wuxinyou/05-XBotHighCtrlBox/02-核心板/软件设计-历史/qtxbot4412_20170221_2/images/start副本.png

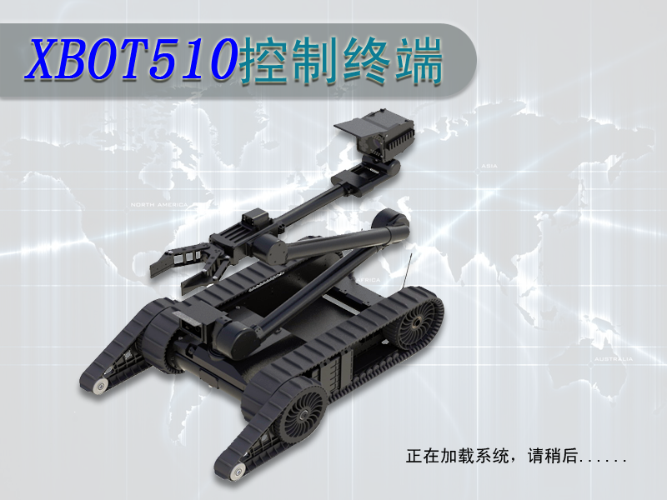
02-核心板/软件设计-历史/qtxbot4412_20170221_2/images/start副本.png
