wuxinyou/05-XBotHighCtrlBox/02-核心板/软件设计-历史/qtxbot4412_20170221/images/start.png

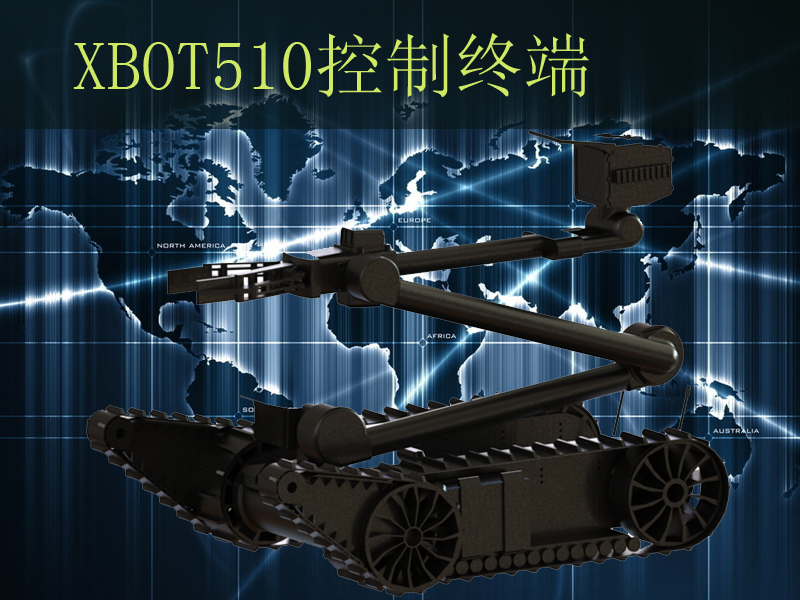
02-核心板/软件设计-历史/qtxbot4412_20170221/images/start.png
