wuxinyou/05-XBotHighCtrlBox/03-基板/软件设计/XbotUpCtrlBoxV2.2.2/ReadMe.txt

XbotUpCtrlBoxV2.1
20170427
1.本程序适用于新版的基板，实现电源开关软自锁。

XbotUpCtrlBoxV2.1
20170427
1.修改波特率

XbotUpCtrlBoxV2.2.2
20170428
1.添加PB12：PowerOutCnt：用于控制核心板上电.
