wuxinyou/05-XBotHighCtrlBox/03-基板/电气设计/CT310高端控制盒基板电路设计/CT310高端控制盒基板电路V1.1/ReadMe.txt

CT310高端控制盒基板电路V1.1
20170428
1.添加PB12：PowerOutCnt：用于控制核心板上电
