wuxinyou/05-XBotHighCtrlBox/02-核心板/软件设计/qtxbot4412_20170427/ReadMe.txt

qtxbot4412_20170221
1.根据最新的qtxbot程序初步移植到4412上
2.主要移植的是摄像头和串口。
3.屏蔽了原来的串口，视屏，3D
4.使用了4412的串口和视频。
5.编译通过，生成可执行文件，但是不可运行。

qtxbot4412_20170221_2
1.去掉4412的串口和视屏后，可以运行。
2.不使用VideoDis，而是直接使用ProcessImage后可以采集视屏。

qtxbot4412_20170221_3
1.采集视屏正常。
2.修改2D显示区的贴图，因为不能显示中文，同时改变了2D显示窗口的大小。
3.模式标签不能显示中文，修改待定。

qtxbot4412_20170221_4
1.添加串口,根据最新协议修改程序数据帧。
2.基本实现串口通信，采用最新协议。
3.实现视屏采集，2D窗口显示。
4.是一个功能基本完善的版本。

qtxbot4412_20170222_1
1.完善串口收发数据的正确性，合理性。
2.该版本添加了发送数据
3.正常接收，发送合理的数据帧，功能基本完善。
4.数据不是很合理，接收数据帧有延迟。

qtxbot4412_20170222_2
1.添加信号强度指示，待测试。
2.修改电量更新显示的问题。
3.接收机器人数据有问题。

qtxbot4412_20170407
1.时隔2个月，重新测试功能。
2.完善了接收数据延迟的问题，将remoteDataIncoming()放在run()中，同时要start线程。
	解决了接收延迟的问题。
3.信号强度只有在接收到机器人数据后才能显示。只有在解决了接收延迟的问题后，
	才能正常显示。
4.问题：接收到的机器人数据和协议有点出入。

qtxbot4412_20170407_2
1.重点解决接收机器人数据和协议有出入的问题。。。
2.在调试Modle_2d时需要将成员disflag=true.
3.添加字库，解决Modle_2d不能显示中文的问题，只要在系统文件中添加字库即可，
	无需添加任何额外代码。

qtxbot4412_20170418
1.根据协议，本体电压应该是robotData.feedData4，而不是robotData.feedData5，先修改之
2.之前使用receiveFrame统一接收基板的按键数据和机器人数据，会发生数据紊乱的情况，
	原因有2个：1.receiveFrame是联合体的，是共享内存；2.接收数据是另外一个线程，
	在处理主线程时，有可能串口接收线程会改变两个线程的共享数据。
	解决方法：分别定义机器人数据和按键数据内存，就不会了，测试通过。

qtxbot4412_20170427
1.完善图像视角被截取的问题，将图片映射到指定尺寸。
2.测试通过。
