wuxinyou/05-XBotHighCtrlBox/02-核心板/软件设计-历史/qtxbot4412_20170221/ReadMe.txt

qtxbot4412_20170221
1.根据最新的qtxbot程序初步移植到4412上
2.主要移植的是摄像头和串口。
3.屏蔽了原来的串口，视屏，3D
4.使用了4412的串口和视频。
5.编译通过，生成可执行文件，但是不可运行。
