wuxinyou/05-XBotHighCtrlBox/02-核心板/叶总资料/xbot/xbot程序集合/readme.txt

XBOT510_CtrlBox（控制箱主控程序）--------蓝色板子，使用avr下载器下载
xbot_dispaly(控制箱液晶屏控制程序)-------绿色板子，使用MDK打开	
xbot_main_ctrl(底盘磨合)-----------------底盘磨合前下载	xbot_main_ctrl(正常控制)程序，并调试好支臂，再下载此程序下载此程序前，一定要将机器人架起来	
xbot_main_ctrl(机械臂磨合)---------------底盘磨合完成，下载此程序，下载前将机器人架起来
xbot_main_ctrl(正常控制)-----------------机械臂磨合完成后，下载此程序，下载完之后一定要初步测试，然后再去测试爬楼梯以及外场测试等

 注意：下载时一定要注意安全，做好防止机器人失控的应对措施
