wuxinyou/05-XBotHighCtrlBox/03-基板/软件设计/测试软件/SerialPort20170416/SerialPort01/ReadMe.txt

SerialPort1
20161103
1.本实例测试C#开发串口调试工具
2.基本实现接收发送功能，还没有进行数据格式化。

SerialPort2
20161107
1.根据网上例程开发的C#串口调试工具
2.基本完成数据的发送和接收，包括Hex发送和接收。

SerialPort20170114
1.用于电子脚扣测试，检测电子脚扣接收信号强度，并显示1s内收到的信号。

SerialPort20170319
1.用于电子脚扣测试，连续发送电击指令，2个周期，每隔10s连续发送20帧。
	ff ff A4 01 80 09 00 00 00 00 00 00 00 2E

SerialPort20170408
1.用于高端控制盒数据帧调试。
2.用于《控制基板STM32->4412核心板：采集的机器人数据帧》的调试。
3.由于上面协议数据帧里的数据都是uint8。
4.基本测试通过，可以使用。

SerialPort20170416
