wuxinyou/05-XBotHighCtrlBox/02-核心板/核心板系统配置/配置说明/LCD更换配置.docx

LCD更换配置

1. 分辨率设置

在s3cfb_wa101s.c文件中原来7.0寸显示的拨码开关处将分辨率改为800X600

s3cfb_wa101s.c截图

2. logo设置

（1）imag2lcd设置生成.c数组

imag2lcd截图

（2） 改变内核驱动s3cfb_ops.c

通过top和left的值可以修改logo在屏幕中的位置，通过i和j值的修改可以改变屏幕的清晰度去除条纹，一般i和j的值与logo分辨率相同。

s3cfb_ops.c截图

3. 内核设置

如果不进行内核设置，在更换完分辨率和logo之后开发板会持续重启

内核配置截图

4. 屏幕显示为下图

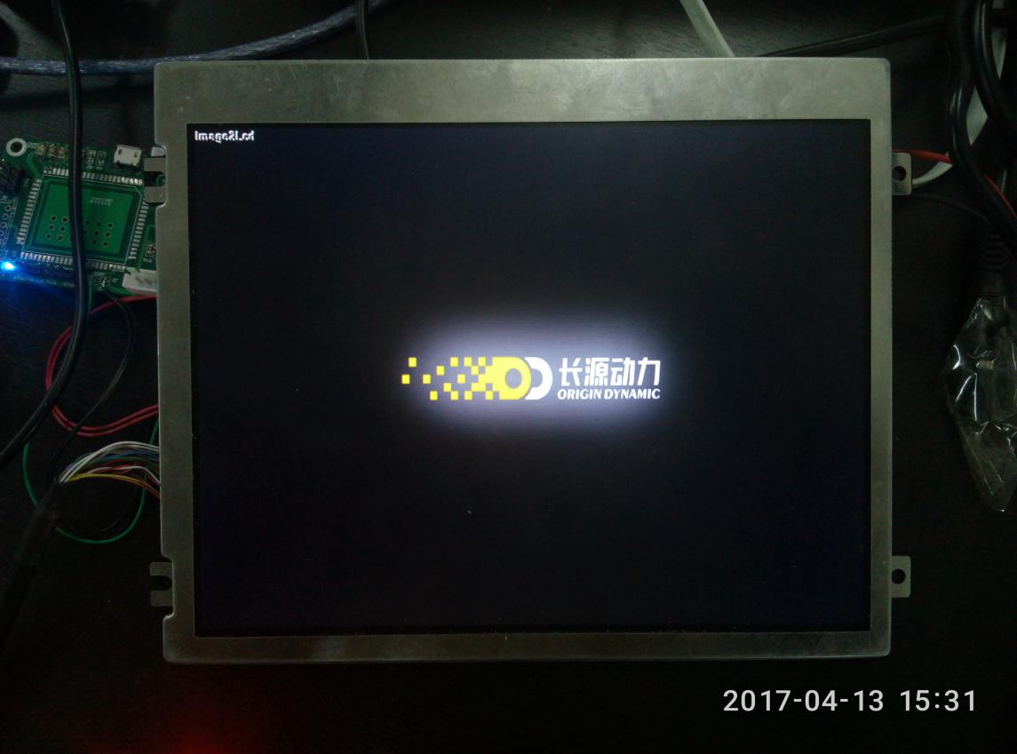
[picture p23: figure]
屏幕截图

5.本文件中包含新logo所需的驱动代码iTop-4412.h
