wuxinyou/05-XBotHighCtrlBox/03-基板/历史/【1】高端控制器整理完成/【3】高端控制盒文档/XBOT控制盒文档资料/XBOT高级控制盒资料/按键开关.docx

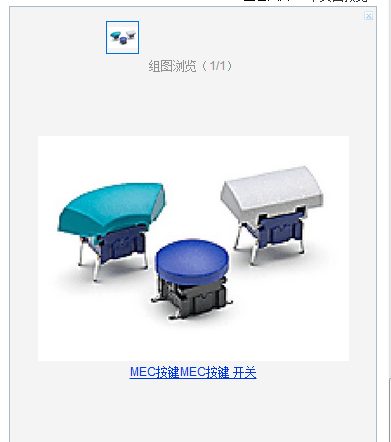
[picture p24: figure]
