wuxinyou/05-XBotHighCtrlBox/05-产品生产/生产文档/3.焊接料单/CT310高端控制盒核心板电路V1.3(ok).xlsx

CT310高端控制盒核心板电路V1.3
参数 | 丝印 | 封装 | 数量 | 备注
CR1220 | BAT1 | BAT1 | 1 | 外购件
22uF/10V | C1, C118 | C1206-S | 2
0.1uF/10V | C2, C112, C117, C129, C130 | C0603-S | 5
10uF/10V | C3 | C0603-S | 1
2.2uF | C4, C6 | C0603-S | 2
0.1uF | C5, C7, C10, C11, C12, C13, C14, C15, C19, C24, C25, C26, C28, C29, C30, C31, C32, C33, C35, C38, C39, C43, C44, C45, C46, C47, C48, C49, C57, C58, C60, C79, C80 | C0603-S | 33
1uF | C8, C9, C16 | C0603-S | 3
0.1uF/NC | C17, C18, C20, C21, C40, C148, C149, C150 | C0603-S | 8 | 不焊
22pF | C22, C23, C36, C37 | C0603-s | 4
22uF | C27, C34 | C1206-S | 2
10uF | C41, C42, C154 | C0603-s | 3
22uF | C50, C93 | C0805-s | 2
1nF | C51, C52, C53, C54, C55 | C0603-S | 5
10uF | C56, C59, C62 | C0805-S | 3
47uF/16v | C61 | C1206-S | 1
1uF/10V | C87, C88, C128 | C0603-S | 3
4.7uF | C89 | C0603-S | 1
560pF | C95 | C0603-S | 1
10nF | C96 | C0603-S | 1
CON40X2_0_8MM | CON10, CON11, con12, CON13 | CON2X40-0_5MM-BB | 4 | 外购件
IN4148 | D1, D2 | D1206 | 2
LED0603 | D3, D4, D5 | LED0603 | 3
500ma | F1 | F1812 | 1
0R/NC | F2 | F1206 | 1 | 不焊
TP_P0_0.8_D0 | H5, H6, H7, H8, H10, H12, H13, H14 | HOLE2_7 | 8
HEADER1X4 | J1 | HD1X4-2.00 | 1 | 不焊
HEADER 30X2 | J2 | HD2X30-2.00 | 1 | 母座，塑高4.6mm
HEADER 2X20 | J3 | HD2X20-2.00 | 1 | 母座，塑高4.6mm
DF19G-20P-1H | J4 | DF19G-20P-1H | 1 | 外购件
sm06b-srss-tb | J5 | sm06b-srss-tb | 1 | 外购件
FFC/SM1.0-5 | J6 | FFC/SM1.0-5 | 1 | 外购件
ZX62RD-AB-5P8 | J7 | MICRO-USB | 1 | 外购件
3.3uH/NC | L1, L2 | L4X4-S | 2 | 不焊
2.2uH | L7 | L3X3MM | 1
S8050 | Q2, Q3 | SOT-23 | 2
AO3415A | Q7 | SOT-23 | 1
8050 | Q8 | SOT-23 | 1
1K | R1, R2, R6, R105, R106 | R0603-S | 5
33K | R3 | R0603-S | 1
10K | R4, R5, R16, R24, R26, R33, R36, R39, R41, R42, R44, R48, R86, R135 | R0603-S | 14
1K/NC | R7 | R0603-S | 1
100K | R8 | R0603-S | 1
22R/NC | R9 | R0603-S | 1 | 不焊
0R | R10, R12, R18, R20, R21, R22, R23, R25, R40, R49, R50, R54, R56, R57, R174 | R0603-S | 15
10K/NC | R11, R30 | R0603-S | 2 | 不焊
37.4R | R13, R14, R19, R32 | R0603-S | 4
75R/NC | R15, R29 | R0603-S | 2 | 不焊
0R/NC | R17, R53, R55 | R0603-S | 3 | 不焊
2.2k/NC | R27, R28 | R0603-S | 2 | 不焊
15K | R31, R119, R120, R128, R129 | R0603-S | 5
49.9R | R34, R35, R37, R38 | R0805-S | 4
NC | R43, R51, R52, R89 | R0603-S | 4 | 不焊
47K | R45 | R0603-S | 1
1M | R46, R47 | R0603-S | 2
38K | R131 | R0603-S | 1
510K | R133 | R0603-S | 1
800K | R165 | R0603-S | 1
800K/NC | R173 | R0603-S | 1
RESET | SW1 | SW4-SMD | 1 | 不焊
TVP5150AM1PBSR | U1 | PFFQ32 | 1
TXS0102DCU | U2, U17 | tssop8 | 2
REG1117-3.3V | U3 | SOT-223 | 1
SP3232EEN | U4 | SO-16 | 1
TSC2004IRTJ | U5 | QFN20 | 1
DM9621ANP | U8 | QFN48-050-0707LH | 1
74ALVC164245DGG | U9 | TSSOP_48 | 1
GM8285C | U12 | TSSOP56 | 1
RT8065ZSP | U22 | soic8-lh | 1
25MHz | Y1 | X4-2_5X3_2 | 1 | (无源晶振)
14.31818MHz | Y2 | CRYSTAL_D200 | 1 | (无源晶振)
