wuxinyou/05-XBotHighCtrlBox/05-产品生产/生产文档/2.电气资料/1.PCB文件&制板信息/CT310高端控制盒制板信息.xlsx

CT210高端控制盒制板信息
序号 | 名称 | 使用地方 | 需要数量 | 层数 | 颜色 | 板材 | 板厚 | 尺寸 | 板号 | 注意信息 | 制板商
1 | CT310高端控制盒A区按键电路V1.0 | 遥控器 | 1 | 2 | 绿色 | FR4 | 2.0mm | 1.26*12.9 |  |  | 深圳顺易捷
2 | CT310高端控制盒B区按键电路V1.0 | 遥控器 | 1 | 2 | 绿色 | FR4 | 2.0mm | 1.26*12.9 |  |  | 深圳顺易捷
3 | CT310高端控制盒A区贴膜V1.0 | 遥控器 | 1 |  |  |  |  |  | 06-152A |  | 东达
4 | CT310高端控制盒B区贴膜V1.0 | 遥控器 | 1 |  |  |  |  |  | 06-152B |  | 东达
5 | CT310高端控制盒H区按键电路V1.0 | 遥控器 | 1 | 2 | 绿色 | FR4 | 1.6mm | 3.7*5.55 |  |  | 深圳顺易捷
6 | CT310高端控制盒IJ区按键电路V1.0 | 遥控器 | 2 | 2 | 绿色 | FR4 | 1.6mm | 2.4*3.5 |  |  | 深圳顺易捷
7 | CT310高端控制盒方向组合按键电路V1.0 | 遥控器 | 1 | 2 | 绿色 | FR4 | 1.6mm | 4.3*4.6 |  |  | 深圳顺易捷
8 | CT310高端控制盒核心板电路V1.3 | 遥控器 | 1 | 2 | 绿色 | FR4 | 1.6mm | 9.5*11.7 |  |  | 深圳顺易捷
9 | CT310高端控制盒基板电路V1.1 | 遥控器 | 1 | 2 | 绿色 | FR4 | 1.6mm | 15.7*20 |  |  | 深圳顺易捷
10 | CT310高端控制盒右摇杆电路V1.1 | 遥控器 | 1 | 2 | 绿色 | FR4 | 1.6mm | 3.73*3.73 |  |  | 深圳顺易捷
11 | CT310高端控制盒左摇杆电路V1.1 | 遥控器 | 1 | 2 | 绿色 | FR4 | 1.6mm | 3.73*3.73 |  |  | 深圳顺易捷
12 | CT310高端控制盒图数传接口电路V1.0 | 遥控器 | 1 | 2 | 绿色 | FR4 | 1.6mm | 1.32*4.42 |  |  | 深圳顺易捷
