wuxinyou/05-XBotHighCtrlBox/03-基板/历史/【1】高端控制器整理完成/【2】高端控制器 最终版电路板汇总/【1】XBTO高端控制盒V1.1/XBTO高端控制盒V1.1/Project Outputs for XBOT高端控制盒V1_1/控制盒基板.xlsx

Comment | Designator | Footprint | Quantity
0.1uF | C1, C4, C9, C12, C13, C24, C25, C79, C80, C85, C86, C105, C106, C108, C110, C113, C114, C115 | C0805 | 18
10uF | C2, C16, C17, C78, C81, C82, C87, C88, C112, C116, C117, C118 | C1206 | 12
15nF | C3 | C0805 | 1
470uF/50V | C5 | CT7343-E | 1
22pF | C6 | R0805 | 1
2200pF | C7 | C0805 | 1
100uF, 16V | C8 | CT7343-E | 1
22uF | C10, C11, C20, C26 | C1206 | 4
100pF | C14, C21, C27, C28, C29, C30, C31, C32, C33, C34, C35, C36, C37, C38, C39, C40, C41, C42, C43, C44, C45, C46, C47, C48, C49, C50, C51, C52, C53, C54, C55, C56, C57, C58, C59, C60, C61, C62, C63, C64, C65, C66, C67, C68, C71, C72, C73, C74 | C0805 | 48
100uF/16V | C15 | CT7343-E | 1
0.1uF | C18, C19, C119, C120, C121 | C1206 | 5
100pF | C22, C23 | C1206 | 2
1uF | C69, C70 | C0805 | 2
470uF/35V | C77, C83 | CT7343-E | 2
47uF/35V | C84 | CT7343-D | 1
0.1uF | C89, C91, C92, C93, C97, C98, C100, C101, C102, C104 | C0603 | 10
10uF | C90, C95, C96, C99 | C0805 | 4
100pF | C94, C103 | C0603 | 2
15pF | C107, C109, C111 | C0805 | 3
SM8S14A | D1, D2 | DO-218AB | 2
MBRS410LT3 | D3, D4, D5, D6 | SMC | 4
MBRS3201T3G | D7 | SMC | 1
1SMA5.0AT3G | D8, D9 | SMA-S | 2
1SMA5.0AT3G | D10, D11, D12, D13, D14, D15, D16, D17, D18, D19, D20, D21, D22, D23, D24, D25, D26, D27, D28, D29, D30, D31, D32, D33, D34, D35, D36, D37, D38, D39, D40, D41, D42, D43, D44, D45, D46, D47, D48, D49, D50, D51, D52, D53, D57, D59 | SMA | 46
1.5SMC15AT3G | D56, D58 | SMC | 2
LED-G | D60, D61 | LED0805 | 2
1.5SMC6.8CA | D62, D63, D64 | SMC | 3
2A | F1, F2, F3, F4 | F1812 | 4
SP3232EEN | IC1 | SO16-150 | 1
SP3078EEN-L/TR | IC2, IC3, IC4 | SO-8 | 3
HD1X8-2.00 | J2 | SHD1X8-2.00 | 1
Socket | J4, J5, J6, J7, J8, J9, J10, J12, J13, J14 | HT-M3 | 10
SW4 | K_H1, K_H2, K_H3, K_H4, K_H5 | SW-MEC | 5
15uH,1.5A | L1 | L5050-P | 1
15uH,1.5A | L2, L3 | L3030-P | 2
10uH | L4 | L0603-C | 1
Header 6 | P1, P20 | DS1X6-2.54 | 2
KEY_A | P2, P3 | HDR1X9 | 2
Header 8 | P6 | FFC/SM1.0-8 | 1
SMT-8P | P8 | 1MM25_8PIN_SMT_R90 | 1
Header 6 | P9, P10 | FFC/SM1.0-6 | 2
五线触摸屏接口 | P11 | DS1X5-2.54 | 1
RTC备用电池 | P12 | CR2428 | 1
备用视频输入输 | P13 | DS1X4-2.54 | 1
振动电机1 | P15 | 1MM25_2PIN_SMT_R90 | 1
Header 10 | P16, P21 | DS1X10-2.54 | 2
音频接口 | P17 | DS1X8-2.54 | 1
振动电机2 | P18 | 1MM25_2PIN_SMT_R90 | 1
8R 喇叭接口 | P19 | DS1X2-2.54 | 1
17W2 | P22 | 17W2_FEMALE | 1
Header 8 | P23, P25 | DS1X8-2.54 | 2
Header 4 | P24 | DS1X4-2.54 | 1
Header 15X2 | PA1, PB1 | HDR2X15 | 2
8050 | Q1, Q2 | SOT-23 | 2
BCP54 | Q3, Q4 | SOT-223 | 2
0K | R0 | R0603 | 1
1K | R1, R83, R84, R95, R96, R122, R123 | R0805 | 7
348K | R2 | R0805 | 1
64.9K | R3 | R0805 | 1
205K | R4 | R0805 | 1
35.7K,1% | R5 | R0805 | 1
53.6K,1% | R6 | R0805 | 1
10K | R7, R8, R11, R12, R104, R105, R106 | R0805 | 7
100K | R9, R10 | R0805 | 2
4.7K | R13, R14, R15, R16, R17, R23, R24, R25, R26, R31, R32, R33, R34, R39, R40, R41, R42, R47, R48, R49, R50, R55, R56, R59, R60, R61, R65, R66, R67, R71, R72, R73, R77, R78, R79, R85, R86, R89, R90, R93 | R0805 | 40
0.33K | R18, R19, R20, R21, R22, R27, R28, R29, R30, R35, R36, R37, R38, R43, R44, R45, R46, R51, R52, R53, R54, R57, R58, R62, R63, R64, R68, R69, R70, R74, R75, R76, R80, R81, R82, R87, R88, R91, R92, R94 | R0805 | 40
10K | R97, R98, R99 | R0603 | 3
470R | R100, R101 | R0805 | 2
4.7R | R102, R103 | R0805 | 2
2K | R107, R109, R110, R112, R113, R115 | R0805 | 6
120R(不焊) | R108, R111, R114 | R0805 | 3
10R | R116, R117, R118, R119, R120, R121 | R0805 | 6
SW-4 | S1, S2 | SW-MEC-5 | 2
TPS54160-C1 | U1 | TSSO3X5-G10 | 1
MC33275DT-3.3 | U2 | TO-252 | 1
REF192 | U3 | SO-8 | 1
TDA7267 | U4 | DIP8 | 1
STM32F103VCT6 | U5 | STM32F103VCT6 | 1
XTAL 8MHz | Y1 | XTAL 5.0X7.0-SM | 1
