wuxinyou/05-XBotHighCtrlBox/05-产品生产/生产文档/4.外购件清单/外购件清单-CT310高端控制盒20170426.xlsx

Sheet: 外购件
物料采购需求单 编号：
申请部门：生产部 |  |  | 项目名称：30套xbot高端控制盒 |  |  |  |  |  | 申请日期：2017/04/20
编号 | 物料名称 | 规格型号 | 所需数量 （个） | 库存数量 （个） | 安全库存量 （个） | 采购数量 （个） | 采购单价 （元） | 采购总价 （元） | 采购事由 | 备注
1 | 二维摇杆 |  | 2 | 0 | 10 | 100 |  |  |  | https://item.taobao.com/item.htm?id=544439099342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
2 | 8.4寸液晶屏 | LQ084S3LG03 | 1 |  |  |  |  |  |  | 15510088223，戴小姐 QQ：2721162196
3 | pcb板焊点铜柱，M3X4 |  | 4 |  |  |  |  |  |  | https://item.taobao.com/item.htm?spm=a230r.1.14.149.PJjIvW&id=42387569087&ns=1&abbucket=3#detail
4 | I,J区:丹麦MEC按键开关灰色复位开关微动开关3ATH9 + 1M 03 |  | 4 |  |  |  |  |  |  | https://item.taobao.com/item.htm?spm=2013.1.0.0.SlMnar&id=44280098442
5 | E,F区: 丹麦MEC按键开关黑色复位开关微动开关3ATH9+1ZB09 3FTH9+1ZC09 |  | 2 |  |  |  |  |  |  | https://item.taobao.com/item.htm?spm=a1z10.3-c.w4002-182903973.17.D0S9Wo&id=44336098748
6 | H区：丹麦MEC按键开关黑色复位开关微动开关3FTH9 + 1P 09 原装正品 |  | 5 |  |  |  |  |  |  | https://item.taobao.com/item.htm?spm=a1z10.3-c.w4002-182903973.10.rIws8S&id=44283862474
7 | LVDS液晶座 DF19G-20P-1H 1.0MM间距 20P 贴片针座 HRS原装 |  | 1 |  |  |  |  |  |  | https://item.taobao.com/item.htm?id=42592471726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
8 | LEMO插头插座 推拉自锁 插头插座 FGG/EGG.2B-16芯 连接器 | FGG/EGG.2B-16 | 1 |  |  |  |  |  |  | https://item.taobao.com/item.htm?spm=a230r.1.14.79. xtDNez&id=536641064705&ns=1&abbucket=19#detail
9 | LEMO插头插座 推拉自锁 插头插座 FGG/EGG.2B-19芯 连接器 | FGG/EGG.2B-19 | 1 |  |  |  |  |  |  | https://item.taobao.com/item.htm?spm=a230r.1.14.24.hjACl8&id=534446114473&ns=1&abbucket=19#detail
10 | 按钮开关GQ12系列金属球型按钮,红色球头 | GQ12B-10/J/R/A | 1 |  |  |  |  |  |  | https://detail.tmall.com/item.htm?id=35786413714&cm_id=140105335569ed55e27b&abbucket=19
11 | 按钮开关GQ12系列金属球型按钮，黑色球头 | GQ12B-10/J/N/A | 3 |  |  |  |  |  |  | https://detail.tmall.com/item.htm?id=35786413714&cm_id=140105335569ed55e27b&abbucket=19
12 | 红波按钮 不锈钢钥匙开关,1NO1NC | LAS1-AGQ-□Y∕◆● | 1 |  |  |  |  |  |  | https://detail.tmall.com/item.htm?id=35786413714&cm_id=140105335569ed55e27b&abbucket=19
13 | 红波按钮 不锈钢自复位开关,环形红色12V灯,1NO1NC | LAS2GQF-□■E∕△∕▲∕◎∕☆ | 1 |  |  |  |  |  |  | https://detail.tmall.com/item.htm?id=35786413714&cm_id=140105335569ed55e27b&abbucket=19
14 | 三星四核Exynos CortexA9开发板 iTOP-4412核心板 SCP 1GB/4GB (对接的连接器属于附属品，要说明提供，每个板子配套4个连接器) |  | 1 |  |  |  |  |  |  | https://item.taobao.com/item.htm?id=35379531422&spm=2014.21600712.0.0&qq-pf-to=pcqq.c2c
15 | 锅仔片 薄膜开关 10MM |  | 20 |  |  |  |  |  |  | https://detail.tmall.com/item.htm?id=43782987769&cm_id=140105335569ed55e27b&abbucket=3
16 | 1.2G图传接收机(只需要接收机)(同XBOT机器人控制箱使用的图传) |  | 1
17 | 433MHz数传，19200波特率，485接口，7.2V供电(同XBOT机器人本体使用的数传) |  | 1 |  |  |  |  |  |  | 深圳华奥通
18 | 12V电池，131x56x21mm，用3200mah的18650电芯做，保护板持续电流3A，保护电流5A |  | 1 |  |  |  |  |  |  | 定制
19 | 12V继电器,6脚，2路常开 | G6B-2214P-US-12V | 2 |  |  |  |  |  |  | https://item.taobao.com/item.htm?spm=a230r.1.14.22.dBAQNm&id=41733682965&ns=1&abbucket=3#detail
20 | microUSB母座 |  | 1 |  |  |  |  |  |  | https://detail.tmall.com/item.htm?id=42481773625&ali_trackid=1_7aaa746ca6c8d28d7c58046034fdf01c
21 | 1.2G天线BNC接头，同XBOT控制箱 |  | 1
22 | 433MHz天线，通XBOT控制箱 |  | 1
23
24
25
26
27
28
29
30
31
32
33
34
35
36
37
38
39
40
41

Sheet: 接插件&线材
接插件&线材清单
序号 | 元件 名称 | 参数 型号 | 单套 数量 | 单价 | 小计 | 购买 数量 | 购买 单价 | 小计 | 备注 | 购买 时间 | 供应商 | 联系 方式
1 | ZH1.5mm间距 2P，卧贴，配套胶壳 | ZH1X2WT-1.5 | 2 |  |  |  |  |  |  |  | https://item.taobao.com/item.htm?spm=a1z10.5-c.w4002-828583740.21.CnEtvi&id=41924865971
2 | ZH1.5mm间距 9P，卧贴，配套胶壳 | ZH1X9WT-1.5 | 4
3 | ZH1.5mm间距 5P，卧贴，配套胶壳 | ZH1X5WT-1.5 | 4
4 | ZH1.5mm间距 8P，卧贴，配套胶壳 | ZH1X8WT-1.5 | 2
5 | ZH1.5mm间距 4P，卧贴，配套胶壳 | ZH1X4WT-1.5 | 4
6 | ZH1.5mm间距 2P，卧贴，配套胶壳 | ZH1X2WT-1.5 | 1
7 | ZH1.5mm间距 7P，卧贴，配套胶壳 | ZH1X7WT-1.5 | 2
8 | ZH1.5mm间距 4P，立贴，配套胶壳 | ZH1X4LT-1.5 | 3
9 | ZH1.5mm间距 5P，立贴，配套胶壳 | ZH1X5LT-1.5 | 3
10 | ZH1.5mm间距 6P，立贴，配套胶壳 | ZH1X6LT-1.5 | 2
11 | ZH1.5mm间距 7P，立贴，配套胶壳 | ZH1X7LT-1.5 | 1
12 | 1.5mm配套线材，双头线，不插，长度60mm | 颜色，黄 | 50条 |  |  |  |  |  |  |  | https://item.taobao.com/item.htm?spm=a230r.1.14.286.kTlnd3&id=40034991481&ns=1&abbucket=3#detail
13 | 1.5mm配套线材，双头线，不插，长度60mm | 颜色，黑 | 10条
14 | 1.5mm配套线材，双头线，不插，长度60mm | 颜色，红 | 10条
15 | 1.0MM间距6P卧贴,带胶壳，带线，线长100mm | sm06b-srss-tb | 1 |  |  |  |  |  |  |  | https://item.taobao.com/item.htm?spm=a230r.1.14.8.eNyoXl&id=38889497402&ns=1&abbucket=3#detail
16 | 液晶屏20P屏线定制，线长60mm |  | 1 |  |  |  |  |  |  |  | 杨鑫，QQ1055212134，手机：13683364748
17 | 2.00mm间距双排母，塑高4.6mm |  | 2 |  |  |  |  |  |  |  | https://item.taobao.com/item.htm?spm=a230r.1.14.41.4Dnwr3&id=522572885533&ns=1&abbucket=3#detail
18 | 2.00mm间距双排针，正常高度 |  | 1
19 | DC电源线母接头5.5mm |  | 1 |  |  |  |  |  |  |  | https://item.taobao.com/item.htm?spm=a230r.1.14.304.zlGXAq&id=539126918394&ns=1&abbucket=3#detail
20 | BNC带法兰转SMA内螺纹内针，总长130mm |  | 2 |  |  |  |  |  |  |  | https://item.taobao.com/item.htm?spm=a230r.1.14.37.Qp1W1a&id=532194905742&ns=1&abbucket=3#detail
21 | 双排针,双塑2.54间距,针长30mm |  | 1 |  |  |  |  |  |  |  | https://item.taobao.com/item.htm?spm=a1z10.5-c.w4002-1531767097.34.1V0uZ1&id=40039912006
22 | 贴片排母2.54mm间距 母座2*12Pin插座 |  | 1 |  |  |  |  |  |  |  | https://item.taobao.com/item.htm?spm=a1z10.5-c.w4002-1531767097.37.1V0uZ1&id=39425247827
23
24
25
26
27
28
29
30
31
32
33
34
35
