wuxinyou/05-XBotHighCtrlBox/05-产品生产/生产文档/3.焊接料单/CT310高端控制盒A区按键电路V1.0(ok).xlsx

CT310高端控制盒A区按键电路V1.0
参数 | 丝印 | 封装 | 数量 | 备注
ZH1X9LT-1.5 | J1 | ZH1X9LT-1.5 | 1 | 外购件-接插件
HEADER1X2 | J2, J3, J4, J5, J6, J7, J8, J9 | 薄膜按键 | 8 | 外购件-锅仔片
