wuxinyou/05-XBotHighCtrlBox/05-产品生产/生产文档/3.焊接料单/CT310高端控制盒H区按键电路V1.0(ok).xlsx

CT310高端控制盒H区按键电路V1.0
参数 | 丝印 | 封装 | 数量 | 备注
ZH1X6WT-1.5 | J1 | ZH1X6WT-1.5 | 1 | 外购件
SW4 | K_H1, K_H2, K_H3, K_H4, K_H5 | SW-MEC | 5 | 外购件
