wuxinyou/05-XBotHighCtrlBox/05-产品生产/生产文档/3.焊接料单/CT310高端控制盒IJ区按键电路V1.0(ok).xlsx

CT310高端控制盒IJ区按键电路V1.0
参数 | 丝印 | 封装 | 数量 | 备注
ZH1X5LT-1.5 | J1 | ZH1X5LT-1.5 | 1 | 外购件-接插件
ZH1X4LT-1.5 | J2 | ZH1X4LT-1.5 | 1 | 外购件-接插件
SW-MEC | J3, J4 | SW-MEC | 2 | 外购件-MEC按键
