wuxinyou/05-XBotHighCtrlBox/05-产品生产/生产文档/3.焊接料单/CT310高端控制盒右摇杆电路V1.1(ok).xlsx

CT310高端控制盒右摇杆电路V1.1
参数 | 丝印 | 封装 | 数量 | 备注
H20JH | J1 | H20JH | 1 | 摇杆，外购件
ZH1X4WT-1.5 | J2 | ZH1X4WT-1.5 | 1
