wuxinyou/05-XBotHighCtrlBox/05-产品生产/生产文档/3.焊接料单/CT310高端控制盒图数传接口电路V1.0(ok).xlsx

CT310高端控制盒图数传接口电路V1.0
参数 | 丝印 | 封装 | 数量 | 备注
HD2X12S-2.54 | J1 | HD2X12S-2.54 | 1 | 外购件-2.54mm间距母座
ZH1X4LT-1.5 | J2 | ZH1X4LT-1.5 | 1 | 外购件
ZH1X6LT-1.5 | J3 | ZH1X6LT-1.5 | 1 | 外购件
ZH1X5LT-1.5 | J4 | ZH1X5LT-1.5 | 1 | 外购件
