wuxinyou/05-XBotHighCtrlBox/05-产品生产/生产文档/3.焊接料单/CT310高端控制盒基板电路V1.1(ok).xlsx

CT310高端控制盒基板电路V1.1
参数 | 丝印 | 封装 | 数量 | 备注
100uF/25V | C1, C7, C8, C19, C20, C53, C72, C86 | CT7343-E-S | 8
2.2uF | C2, C68 | C1206 | 2
0.1uF | C3, C5, C9, C10, C11, C17, C18, C21, C70, C73, C74, C80, C83, C105, C106, C108, C113, C114, C115 | C0805 | 19
22uF | C4, C6, C79, C84 | C1206 | 4
100pF | C12, C13, C23, C24, C25, C26, C27, C28, C29, C30, C31, C32, C33, C34, C35, C36, C37, C38, C39, C40, C41, C42, C43, C44, C45, C46, C47, C48, C49, C50, C51, C52, C54, C55, C56, C57, C58, C59, C60, C61, C62, C63, C64, C65, C66, C67, C71, C75, C77, C81, C82, C87 | C0805 | 52
10uF | C14, C15, C16, C22, C88, C90, C95, C96, C99 | C0805 | 9
1uF | C69, C78 | C0805 | 2
0.01uF | C76, C85 | C0805 | 2
0.1uF | C89, C91, C92, C93, C97, C98, C100, C101, C102, C104 | C0603 | 10
100pF | C94, C103 | C0603 | 2
15pF | C107, C109, C111 | C0805 | 3
10uF | C112 | C1206 | 1
ZMM16 | D3 | SOD-80 | 1
1.5SMC15A | D4 | SMC | 1
ZMM1 | D5, D6, D9 | SOD-80 | 3
SK58 | D7, D8 | SMB | 2
1N4148 | D10 | SOD-80 | 1
LED-G | D60, D61 | LED0805 | 2
1.5SMC6.8CA | D62, D63, D64 | SMB | 3
2.5A | F1, F2 | F1812 | 2 | 可恢复保险
SP3232EEN | IC1 | SO16-150 | 1
SP3078EEN-L/TR | IC2, IC3, IC4 | SO-8 | 3
ZH1X6WT-1.5 | J1, J12, J15, J16 | ZH1X6WT-1.5 | 4
HD1X8-2.00 | J2 | SHD1X8-2.00 | 1 | 不焊
ZH1X2WT-1.5 | J3 | ZH1X2WT-1.5 | 1
ZH1X9WT-1.5 | J4, J5 | ZH1X9WT-1.5 | 2
DS1X7-2.54 | J6, J17 | DS1X7H-2.54 | 2 | 90度弯角
ZH1X5WT-1.5 | J7, J8 | ZH1X5WT-1.5 | 2
ZH1X8WT-1.5 | J9 | ZH1X8WT-1.5 | 1
ZH1X4WT-1.5 | J10, J11 | ZH1X4WT-1.5 | 2
HEADER 30X2 | J13 | HD2X30-2.00 | 1 | 2.0mm双排针，普通高度
HEADER 2X20 | J14 | HD2X20-2.00 | 1 | 2.0mm双排针，普通高度
HEADER2X12 | J18 | HD2X16-2.00 | 1 | 2.54mm双针，高度30mm
ZH1X7WT-1.5 | J19 | ZH1X7WT-1.5 | 1
G6B-2214P-US | K1, K2 | G6B-2214P-Us | 2
10uH | L1 | L0805-C | 1
22uH | L2, L3 | L5050-P | 2
10uH | L4 | L0603-C | 1
S8050 | 'Q1, Q2，Q3, Q5, Q6 | SOT-23 | 5
IRF5210S | Q4 | TO-262 | 1
75R | R1, R37 | R0805 | 2
10K | R2, R12, R104, R105, R106, R107, R109, R110, R112, R113, R115 | R0805 | 11
3.3K | R3, R35 | R0805 | 2
1K | R4, R5, R20, R27, R28, R36, R44, R122, R123 | R0805 | 9
10R | R6, R7, R8, R29, R38, R43, R52, R57, R62, R63, R64, R68, R102, R103, R116, R117, R118, R119, R120, R121 | R0805 | 20
0R | R9, R46 | R0805 | 2
20K | R10, R21, R22 | R0805 | 3
2K | R11 | R0805 | 1
4.7K | R13, R14, R15, R16, R17, R23, R24, R25, R26, R31, R32, R33, R34, R39, R40, R41, R42, R47, R48, R49, R50, R55, R56, R59, R60, R61, R65, R66, R67, R71, R72, R73, R77, R78, R79, R85, R86, R89, R90, R93 | R0805 | 40
0R(N.C) | R18, R19 | R0805 | 2
16K | R30 | R0805 | 1
330R | R45, R53, R54, R58 | R0805 | 4
0R(NC) | R51 | R0805 | 1
10K | R97, R98, R99 | R0603 | 3
470R | R100, R101 | R0805 | 2
LM2596_ADJ | U1, U3 | TO263 | 2
AMS1117-3.3 | U2 | SOT-223 | 1
REF192 | U4 | SO-8 | 1
STM32F103VCT6 | U5 | STM32F103VCT6 | 1
H1102NL | U6 | SOP16 | 1
MBRB60H100CTT4G | U7 | TO-262 | 1
XTAL 8MHz | Y1 | XTAL 5.0X7.0-SM | 1 | 有源晶振
