wuxinyou/05-XBotHighCtrlBox/05-产品生产/生产文档/3.焊接料单/CT310高端控制盒方向组合按键电路V1.0(ok).xlsx

CT310高端控制盒方向组合按键电路V1.0
参数 | 丝印 | 封装 | 数量 | 备注
ZH1X6WT-1.5 | J1 | ZH1X6WT-1.5 | 1
SW-4 | S1 | SW-MEC-5 | 1 | MEC按键，外购件
