wuxinyou/05-XBotHighCtrlBox/05-产品生产/生产文档/1.机加工文件/机械外采件/机械外采件统计.xls

种类 | 名称 | 数量
机械3d打印件 | 挂装盒底 | 1
 | 挂装盒盖 | 1
 | 上面板 | 1
 | 下面板 | 1
机械通用件 | 螺钉黑色沉头十字头自攻 钉M3x6 | 8
 | 六角锁母M3 | 4
 | 螺钉合金钢发黑十字沉头 M3x16 | 4
 | 螺钉合金钢发十字盘头自 攻钉M2.6x6 | 19
 | 螺钉合金钢发十字盘头自 攻钉M3x6 | 6
 | 塑料垫片m3 | 4
 | 螺钉合金钢发十字盘头自 攻钉M3x10 | 8
 | 螺钉合金钢发黑十字沉头 M3x6 | 4
 | 双通铜柱3x12 | 4
 | 螺钉合金钢发黑内六角圆 柱头M3X20 | 4
 | 螺钉不锈钢沉头十字头M 2.3x6 | 8
