wuxinyou/05-XBotHighCtrlBox/03-基板/电气设计/CT310高端控制盒基板电路设计/CT310高端控制盒各按键电路V1.0/3.AB按键贴膜(已投)/CT310高端控制盒A区贴膜V1.0.step

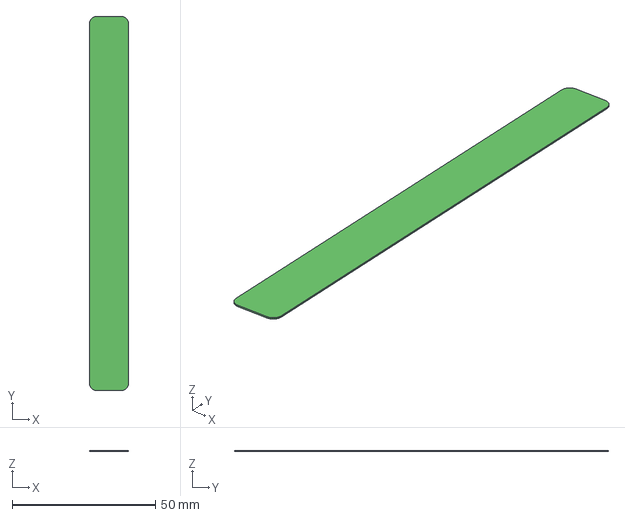
[picture p30: CAD file, 2017-04-27]
03-基板/电气设计/CT310高端控制盒基板电路设计/CT310高端控制盒各按键电路V1.0/3.AB按键贴膜(已投)/CT310高端控制盒A区贴膜V1.0.step
13.6 x 130.6 x 0.391 mm
