wuxinyou/05-XBotHighCtrlBox/03-基板/电气设计/CT310高端控制盒基板电路设计/CT310高端控制盒各按键电路V1.0/4.AB按键(已投)/1.CT310高端控制盒AB按键电路V1.0/CT310高端控制盒AB按键电路V1.0.step

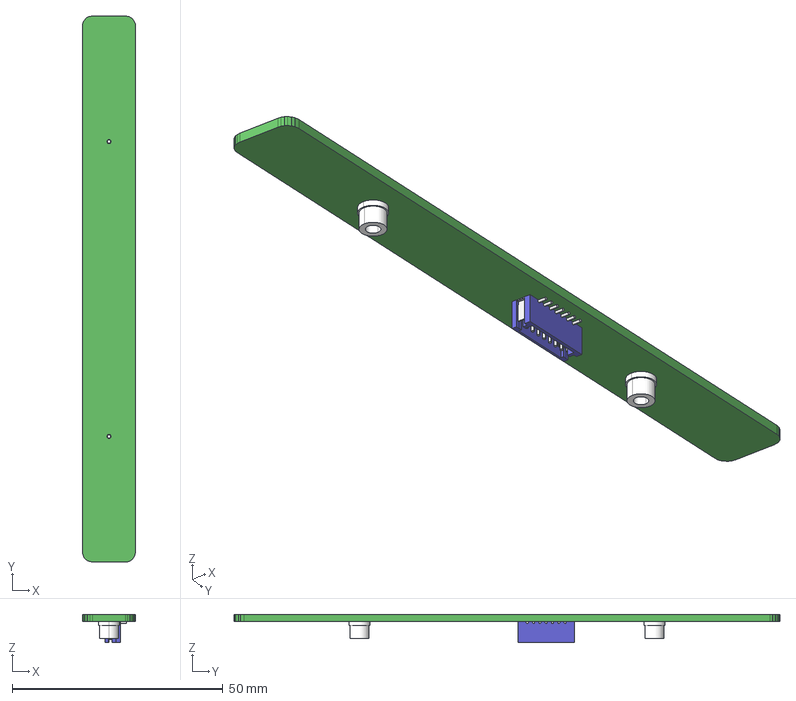
[picture p31: CAD file, 2017-04-27]
03-基板/电气设计/CT310高端控制盒基板电路设计/CT310高端控制盒各按键电路V1.0/4.AB按键(已投)/1.CT310高端控制盒AB按键电路V1.0/CT310高端控制盒AB按键电路V1.0.step
12.6 x 129.6 x 6.67 mm
Board
B7B-ZR-SM4-TF
M3X4+1爾翐 x 2
