wuxinyou/05-XBotHighCtrlBox/03-基板/电气设计/CT310高端控制盒基板电路设计/CT310高端控制盒各按键电路V1.0/5.IJ区按键(已投)/CT310高端控制盒IJ区按键电路V1.0.step

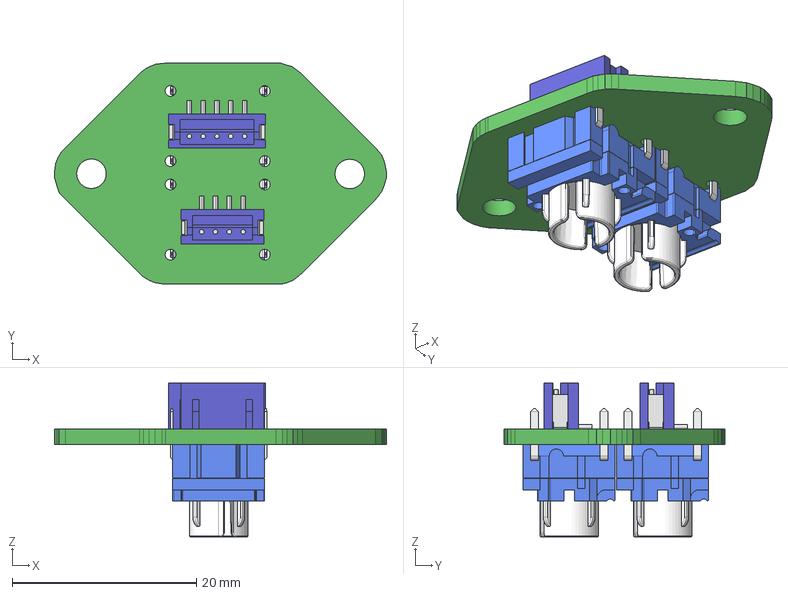
[picture p32: CAD file, 2017-04-27]
03-基板/电气设计/CT310高端控制盒基板电路设计/CT310高端控制盒各按键电路V1.0/5.IJ区按键(已投)/CT310高端控制盒IJ区按键电路V1.0.step
36.1 x 24.0 x 16.7 mm
Board
蓝色高帽按钮 x 2
B4B-ZR-SM4-TF
B5B-ZR-SM4-TF
