wuxinyou/05-XBotHighCtrlBox/03-基板/电气设计/CT310高端控制盒基板电路设计/CT310高端控制盒各按键电路V1.0/6.方向组合按键(已投)/CT310高端控制盒方向组合按键电路V1.0.step

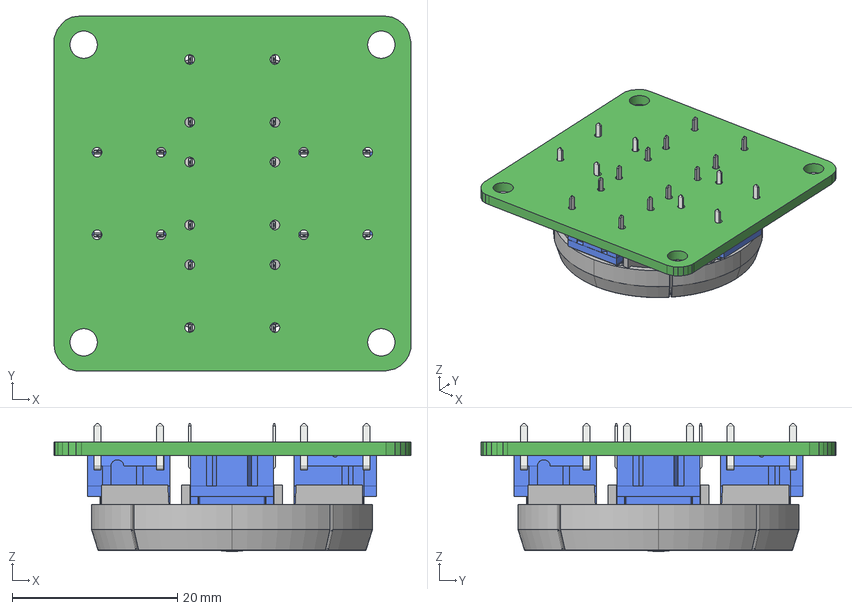
[picture p33: CAD file, 2017-04-27]
03-基板/电气设计/CT310高端控制盒基板电路设计/CT310高端控制盒各按键电路V1.0/6.方向组合按键(已投)/CT310高端控制盒方向组合按键电路V1.0.step
43.2 x 42.9 x 15.5 mm
Board
弧形按键 x 4
蓝色平帽按钮 x 4
蓝色高帽按钮
圆形按键帽
