wuxinyou/05-XBotHighCtrlBox/03-基板/电气设计/CT310高端控制盒基板电路设计/CT310高端控制盒各按键电路V1.0/7.H区按键(已投)/CT310高端控制盒H区按键电路V1.0.step

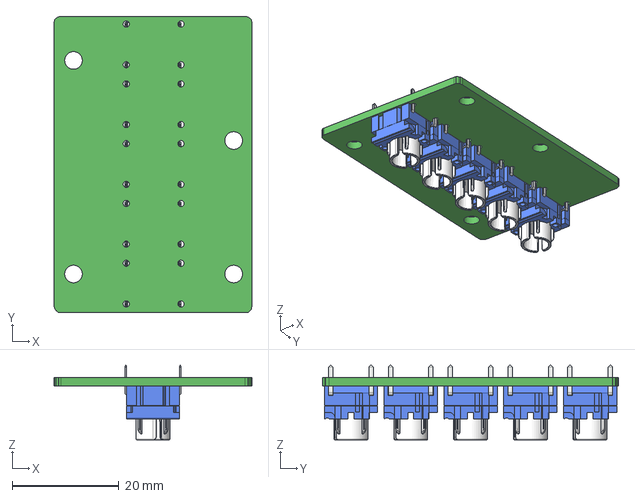
[picture p34: CAD file, 2017-04-27]
03-基板/电气设计/CT310高端控制盒基板电路设计/CT310高端控制盒各按键电路V1.0/7.H区按键(已投)/CT310高端控制盒H区按键电路V1.0.step
37.1 x 55.5 x 14.0 mm
Board
蓝色高帽按钮 x 5
