wuxinyou/05-XBotHighCtrlBox/03-基板/电气设计/CT310高端控制盒基板电路设计/电路板STP文件/CT310高端控制盒A区按键电路V1.0/CT310高端控制盒A区按键电路V1.1.SLDPRT

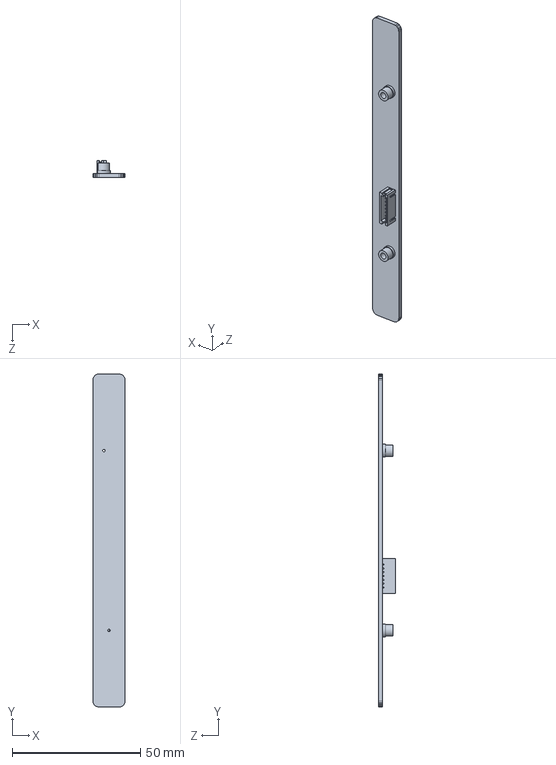
[picture p36: CAD file, 2017-04-27]
03-基板/电气设计/CT310高端控制盒基板电路设计/电路板STP文件/CT310高端控制盒A区按键电路V1.0/CT310高端控制盒A区按键电路V1.1.SLDPRT
12.6 x 129.6 x 6.67 mm
