wuxinyou/05-XBotHighCtrlBox/05-产品生产/生产文档/1.机加工文件/机械外采件/挂装盒底.SLDPRT

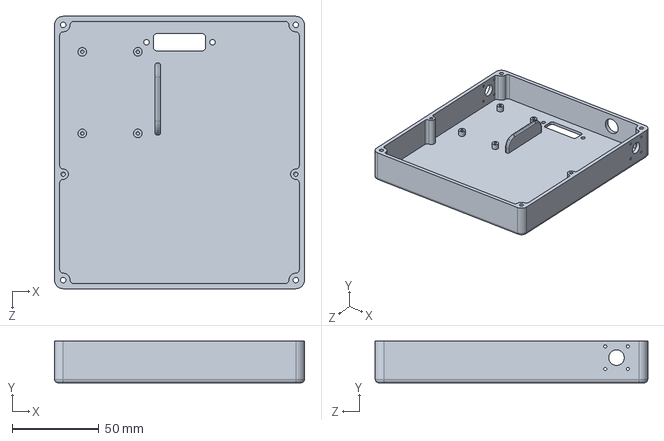
[picture p37: CAD file, 2017-04-28]
05-产品生产/生产文档/1.机加工文件/机械外采件/挂装盒底.SLDPRT
144.0 x 24.0 x 157.0 mm
