wuxinyou/05-XBotHighCtrlBox/03-基板/电气设计/CT310高端控制盒基板电路设计/电路板STP文件/CT310高端控制盒AB按键电路V1.0.step

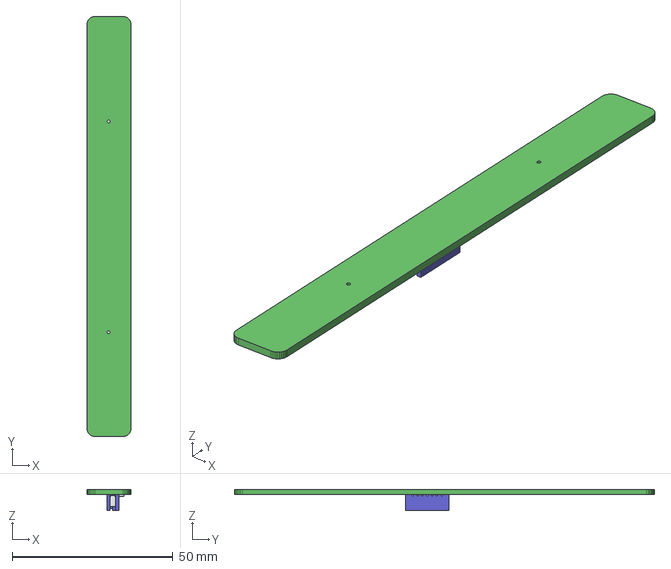
[picture p38: CAD file, 2017-04-27]
03-基板/电气设计/CT310高端控制盒基板电路设计/电路板STP文件/CT310高端控制盒AB按键电路V1.0.step
13.6 x 130.6 x 6.67 mm
Board
B7B-ZR-SM4-TF
