wuxinyou/05-XBotHighCtrlBox/(list of files, cad)

Other CAD files:
03-基板/电气设计/CT310高端控制盒基板电路设计/CT310高端控制盒各按键电路V1.0/4.AB按键(已投)/2.CT310高端控制盒AB按键电路V1.1/CT310高端控制盒AB按键电路V1.1.step
03-基板/电气设计/CT310高端控制盒基板电路设计/CT310高端控制盒各按键电路V1.0/4.AB按键(已投)/3.CT310高端控制盒A区按键电路V1.0/CT310高端控制盒A区按键电路V1.0.step
03-基板/电气设计/CT310高端控制盒基板电路设计/CT310高端控制盒各按键电路V1.0/4.AB按键(已投)/4.CT310高端控制盒B区按键电路V1.0/CT310高端控制盒B区按键电路V1.0.step
03-基板/电气设计/CT310高端控制盒基板电路设计/电路板STP文件/CT310高端控制盒A区按键电路V1.0/CT310高端控制盒A区按键电路V1.0.step
03-基板/电气设计/CT310高端控制盒基板电路设计/电路板STP文件/CT310高端控制盒B区按键电路V1.0/CT310高端控制盒B区按键电路V1.0.step
03-基板/电气设计/CT310高端控制盒基板电路设计/电路板STP文件/CT310高端控制盒H区按键电路V1.0.step
03-基板/电气设计/CT310高端控制盒基板电路设计/CT310高端控制盒各按键电路V1.0/3.AB按键贴膜(已投)/CT310高端控制盒B区贴膜V1.0.step
03-基板/电气设计/CT310高端控制盒基板电路设计/电路板STP文件/CT310高端控制盒A区按键电路V1.0/CT310高端控制盒A区按键电路V1.0.SLDPRT
03-基板/电气设计/CT310高端控制盒基板电路设计/电路板STP文件/CT310高端控制盒B区按键电路V1.0/CT310高端控制盒B区按键电路V1.0.SLDPRT
05-产品生产/生产文档/1.机加工文件/机械外采件/挂装盒底.STL
05-产品生产/生产文档/1.机加工文件/机械外采件/挂装盒盖.STL
