wuxinyou/05-XBotHighCtrlBox/05-产品生产/生产文档/1.机加工文件/机械装配图纸/电池盒.JPG

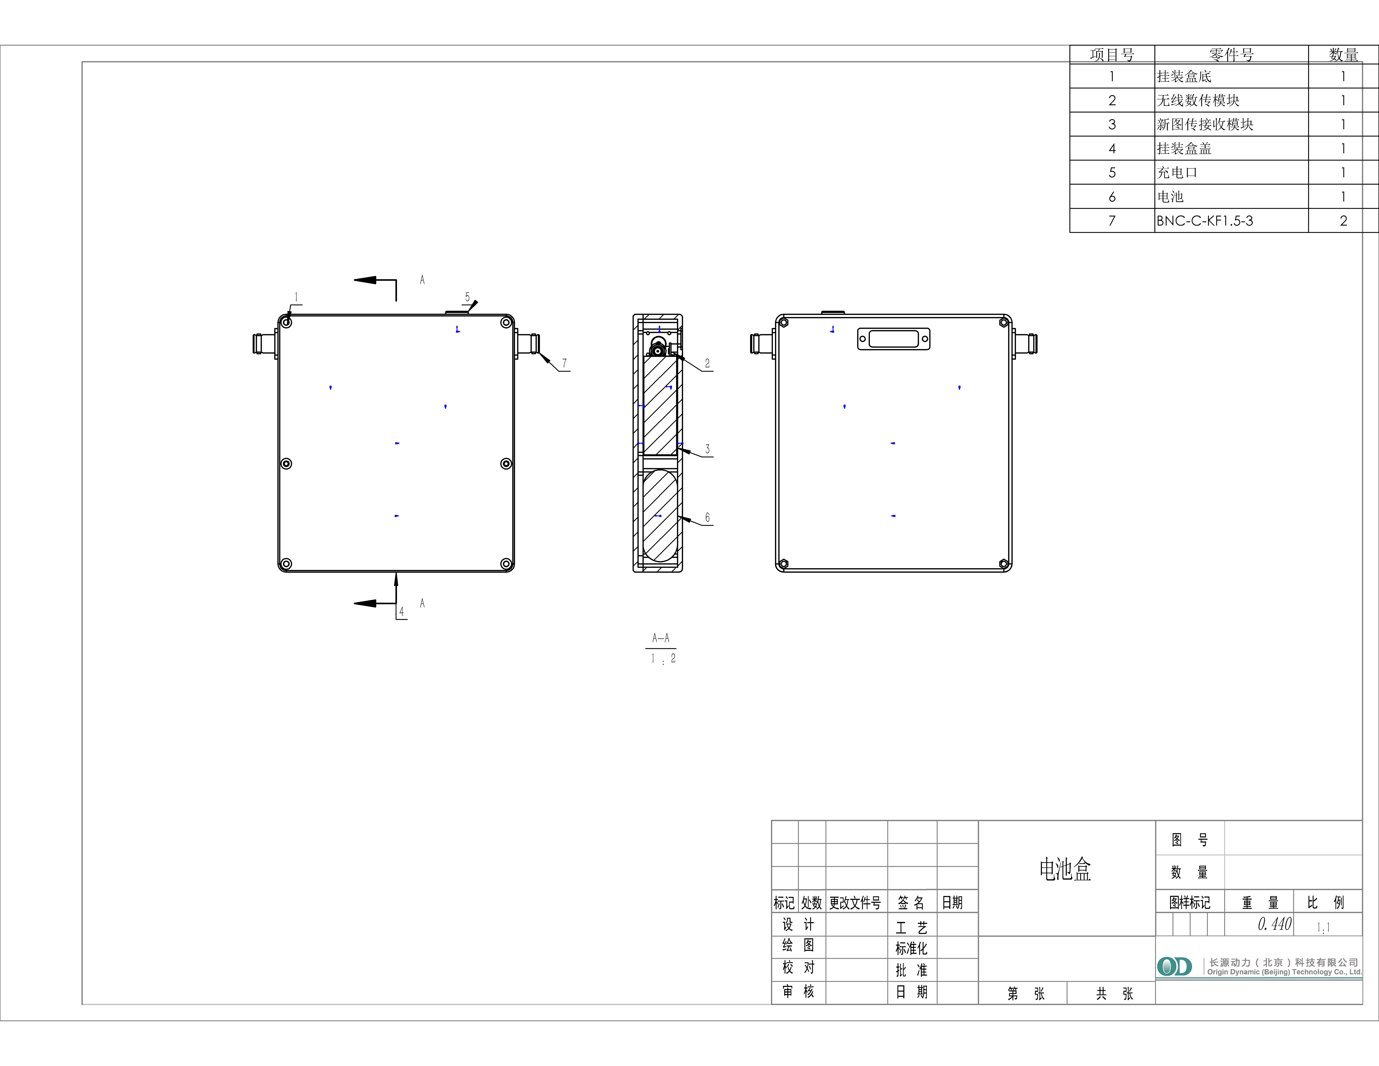
05-产品生产/生产文档/1.机加工文件/机械装配图纸/电池盒.JPG
