wuxinyou/05-XBotHighCtrlBox/03-基板/历史/【1】高端控制器整理完成/【2】高端控制器 最终版电路板汇总/【1】XBTO高端控制盒V1.1/XBTO高端控制盒V1.1/控制盒基板.PDF

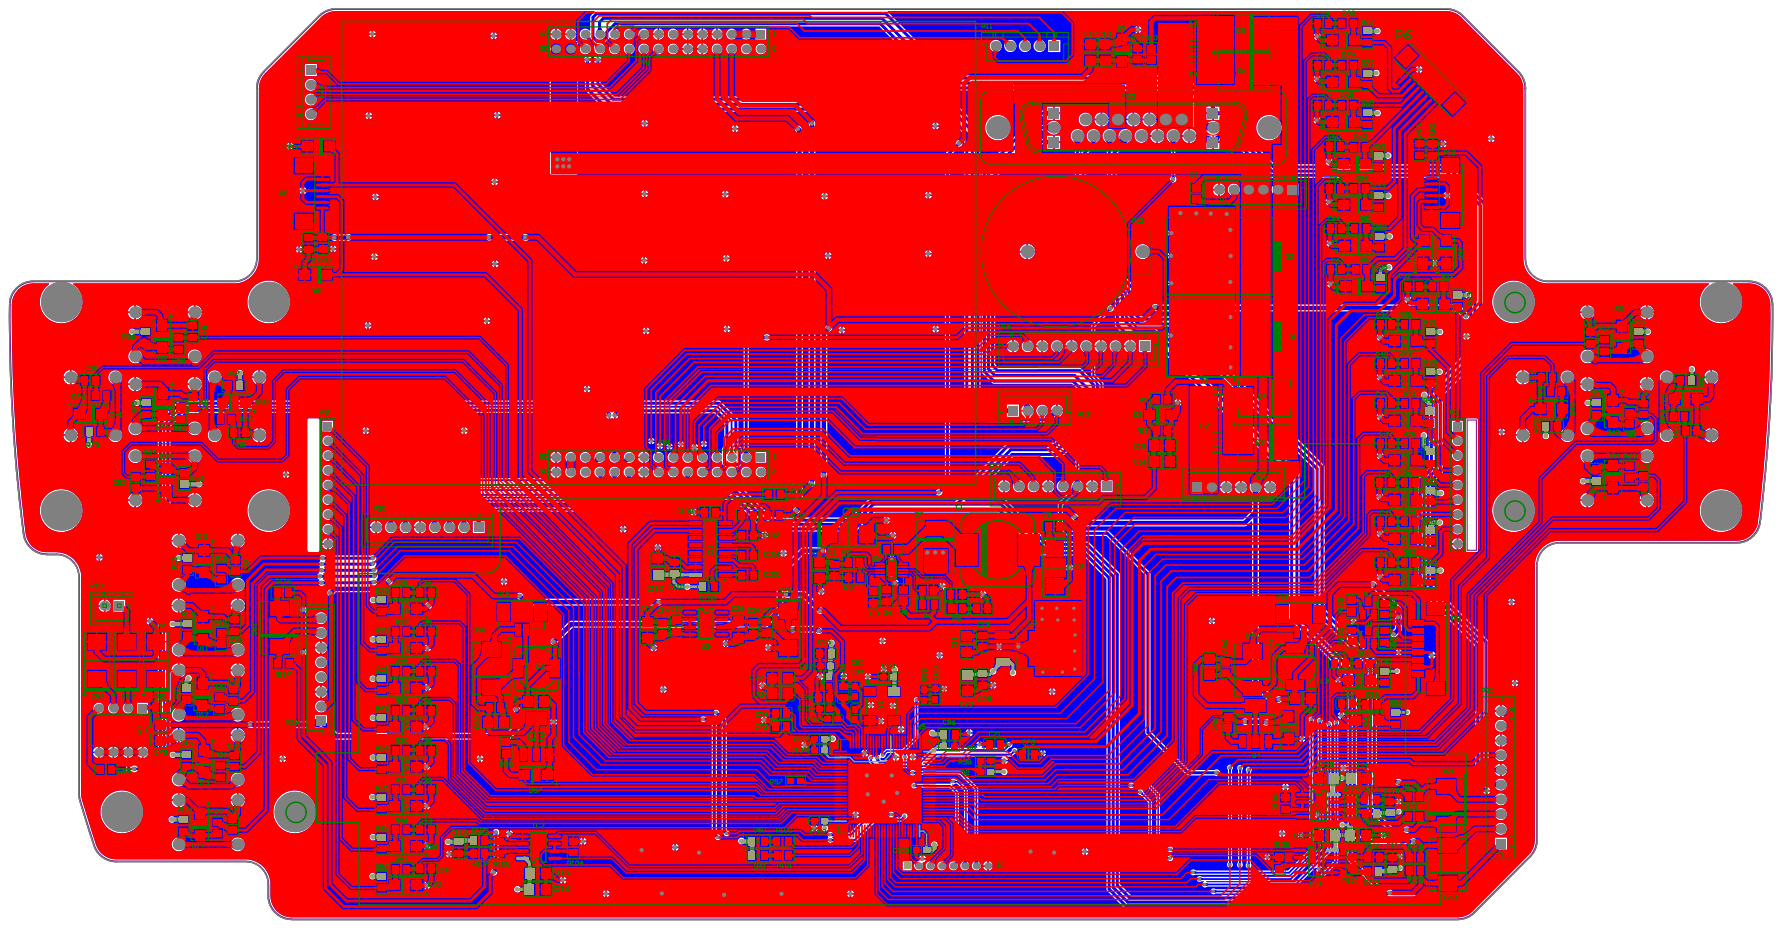
[picture p41: page 1]

Board St
