wuxinyou/05-XBotHighCtrlBox/01-系统设计/架构图/高端控制盒_基板程序_架构.pdf

## 高端控制盒基板程序构架

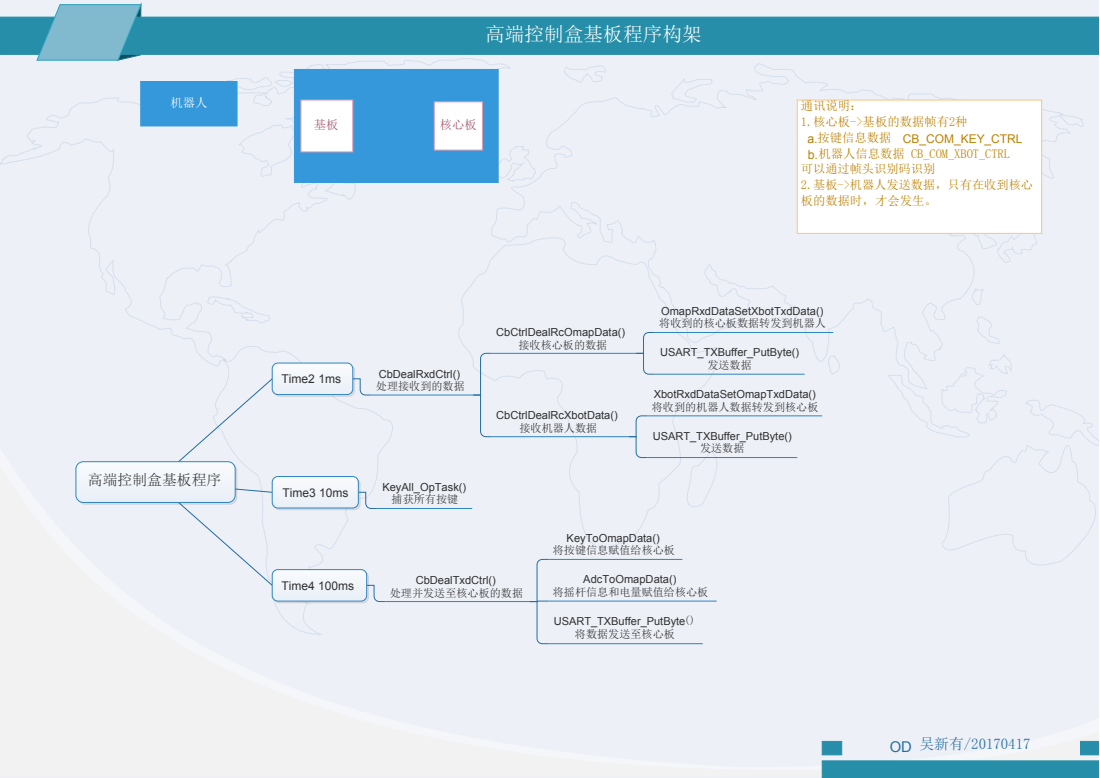
[picture p42: page 1]
Time2 1ms; 高端控制盒基板程序; Time4 100ms; Time3 10ms; CbDealRxdCtrl() 处理接收到的数据; OmapRxdDataSetXbotTxdData() 将收到的核心板数据转发到机器人; KeyAll_OpTask() 捕获所有按键; CbDealTxdCtrl() 处理并发送至核心板的数据; KeyToOmapData() 将按键信息赋值给核心板; AdcToOmapData() 将摇杆信息和电量赋值给核心板; USART_TXBuffer_PutByte() 将数据发送至核心板; CbCtrlDealRcOmapData(); 接收核心板的数据; USART_TXBuffer_PutByte(); 发送数据; CbCtrlDealRcXbotData() 接收机器人数据; XbotRxdDataSetOmapTxdData() 将收到的机器人数据转发到核心板; USART_TXBuffer_PutByte() 发送数据; 机器人; 核心板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
