wuxinyou/05-XBotHighCtrlBox/01-系统设计/架构图/XBotCtrlBox系统通讯链路图.pdf

# XBotCtrlBox系统通讯链路图

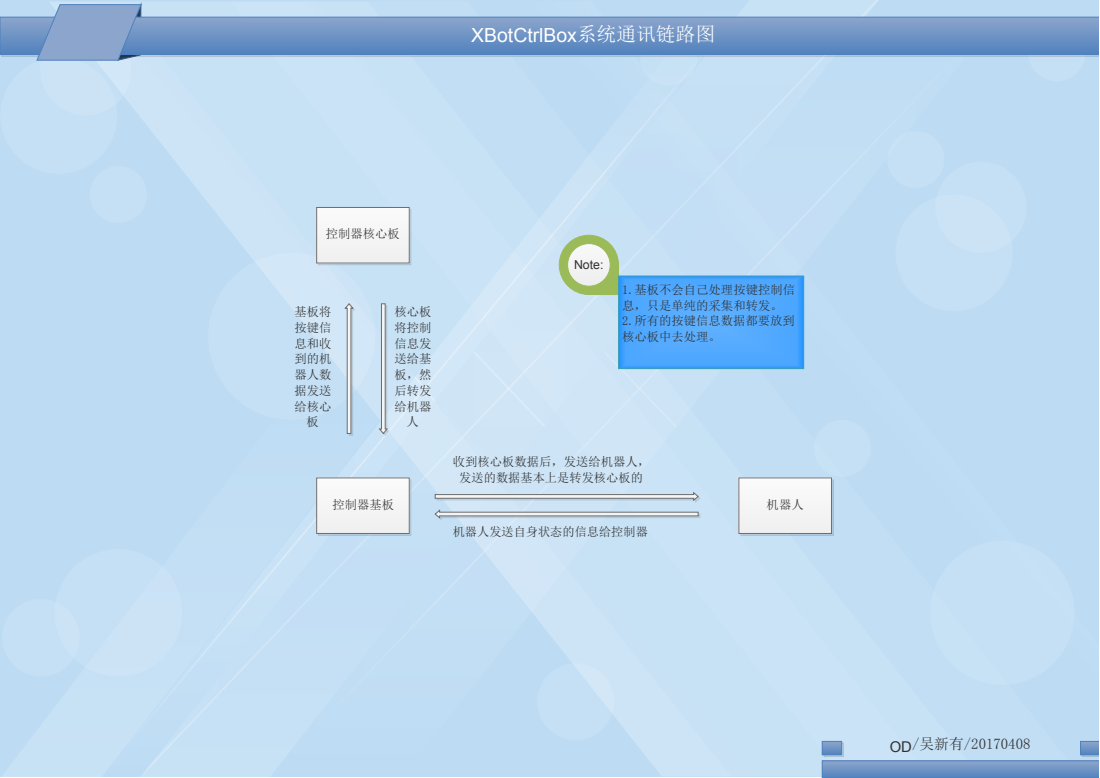
[picture p43: page 1]
控制器核心板; 控制器基板; 机器人; 收到核心板数据后，发送给机器人， 发送的数据基本上是转发核心板的; 基板将 按键信 息和收 到的机 器人数 据发送 给核心 板; 核心板 将控制 信息发 送给基 板，然 后转发 给机器 人; 机器人发送自身状态的信息给控制器; Note:; 1.基板不会自己处理按键控制信 息，只是单纯的采集和转发。 2.所有的按键信息数据都要放到 核心板中去处理。; OD/吴新有/20170408
