wuxinyou/05-XBotHighCtrlBox/02-核心板/电气设计/CT310高端控制盒核心板电路V1.2/CT310高端控制盒核心板电路V1.2.pdf

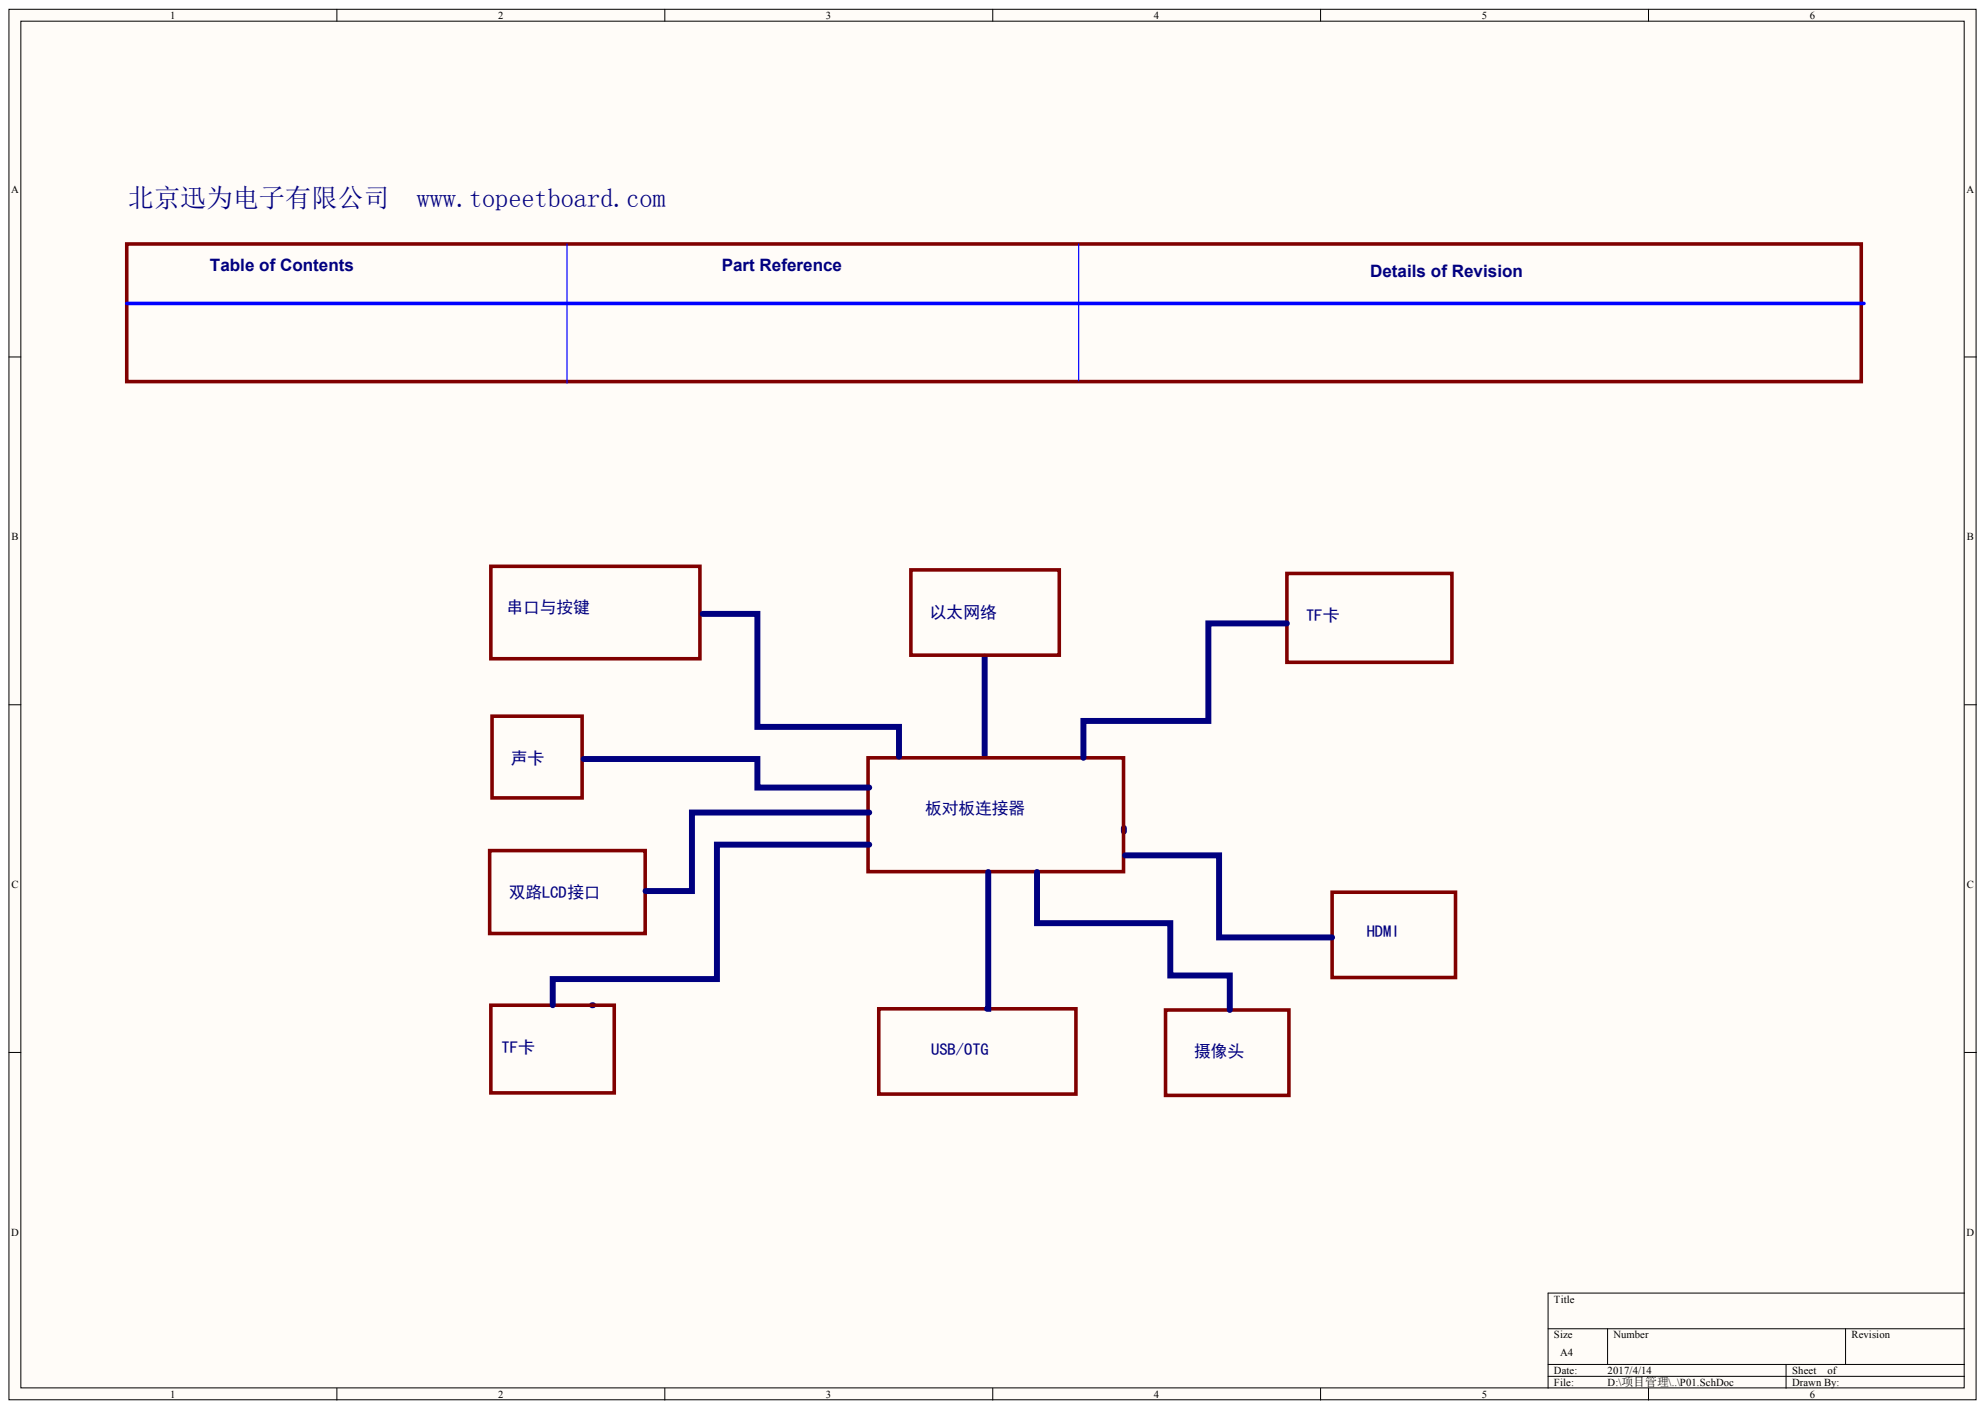
[picture p44: page 1]

北京迅为电子有限公司 www.topeetboard.com

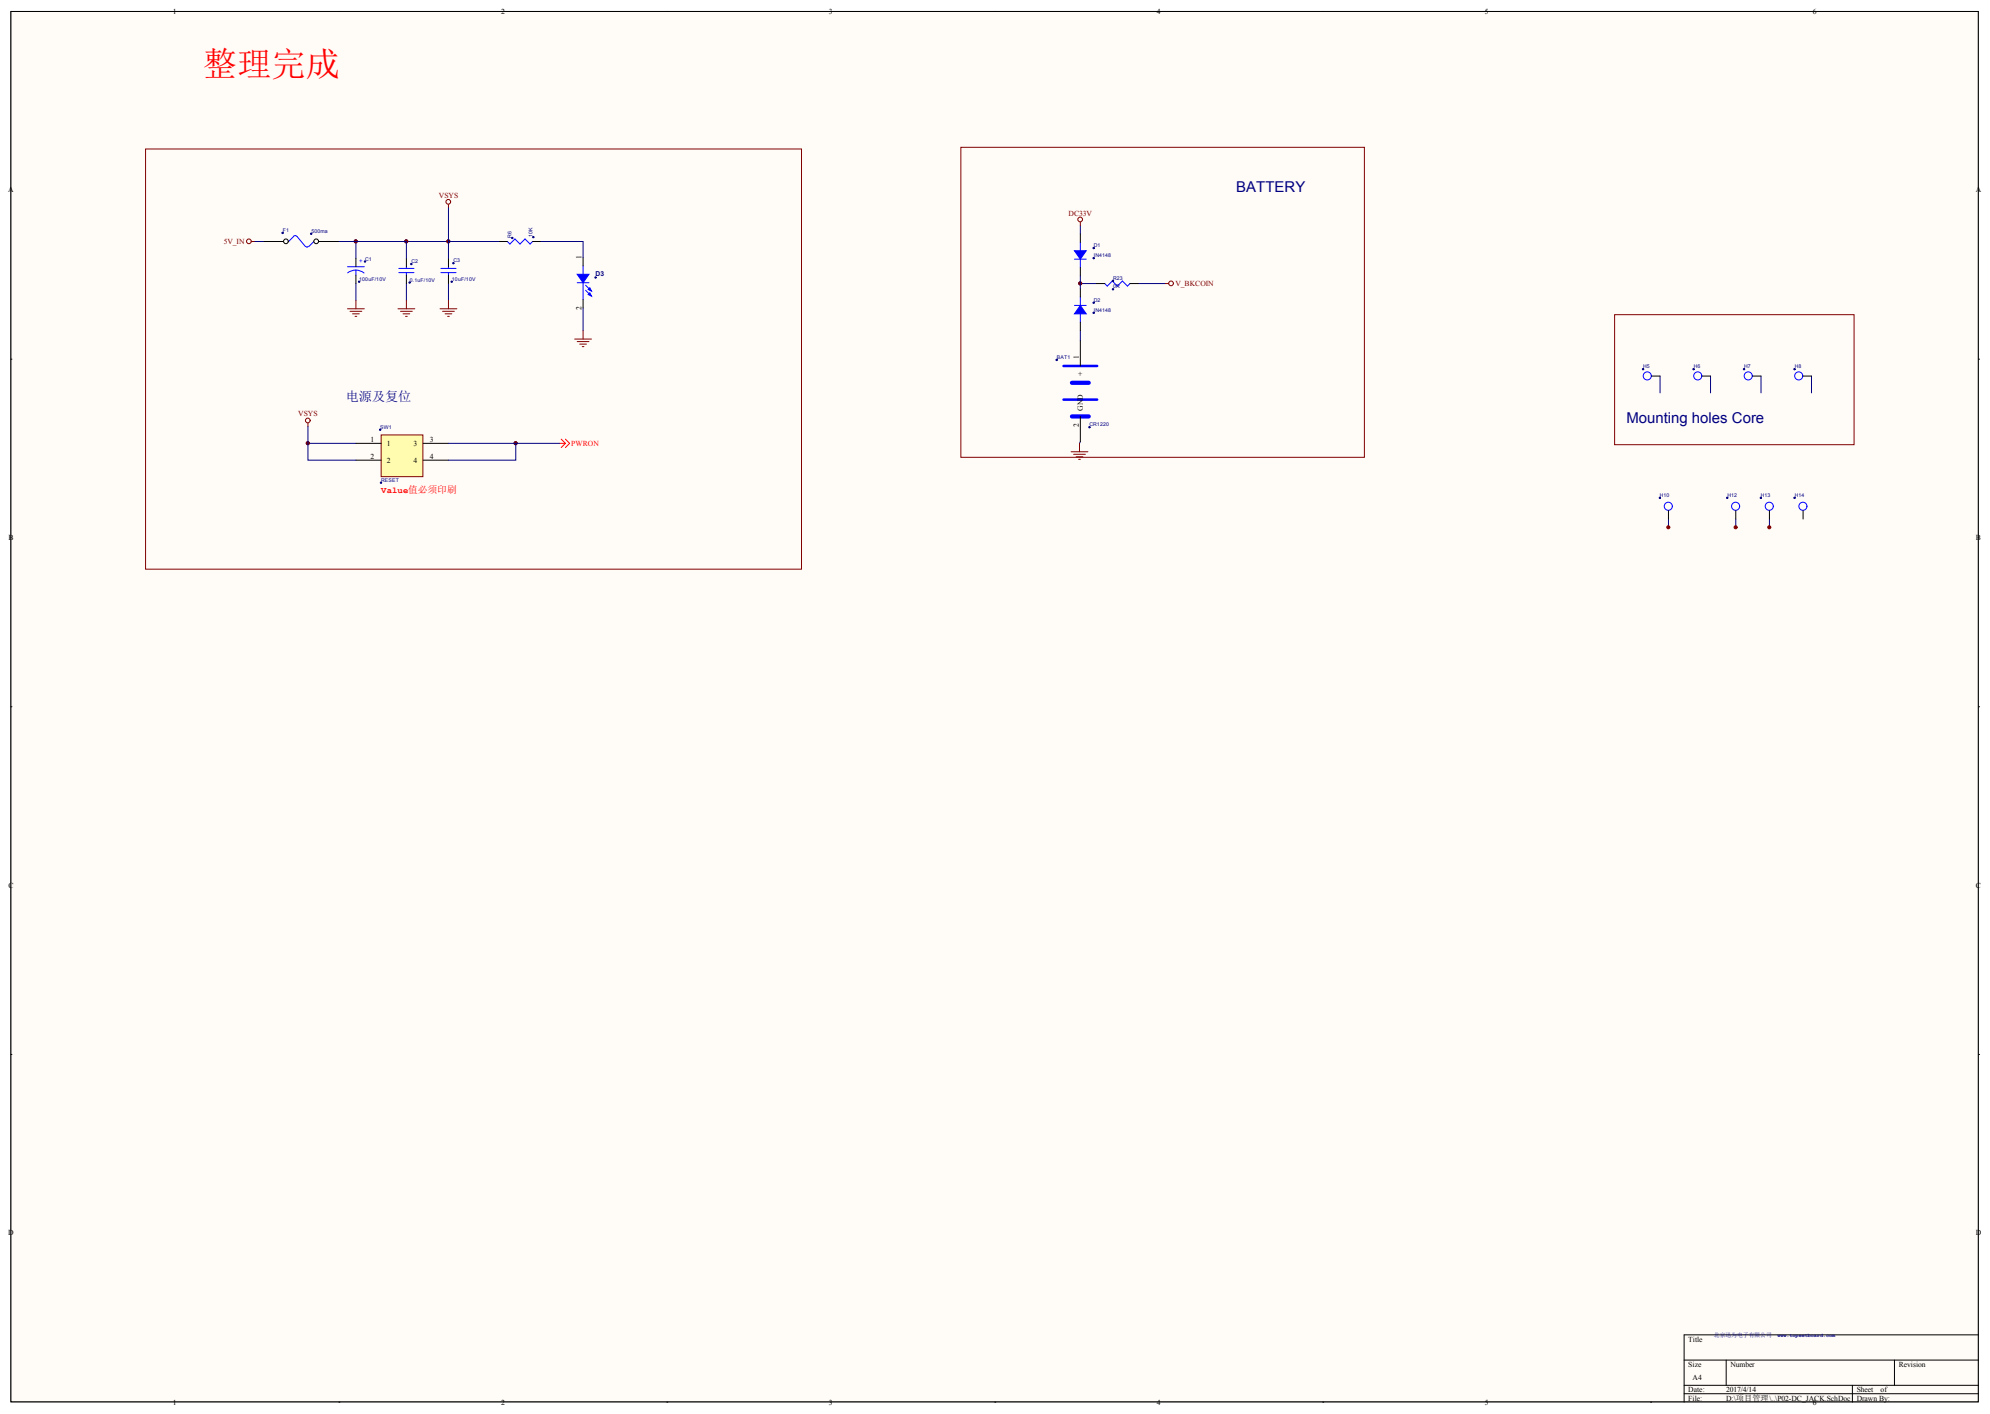
[picture p45: page 2]

H 5 Mounting holes Core | H 6 | H 7 | H 8

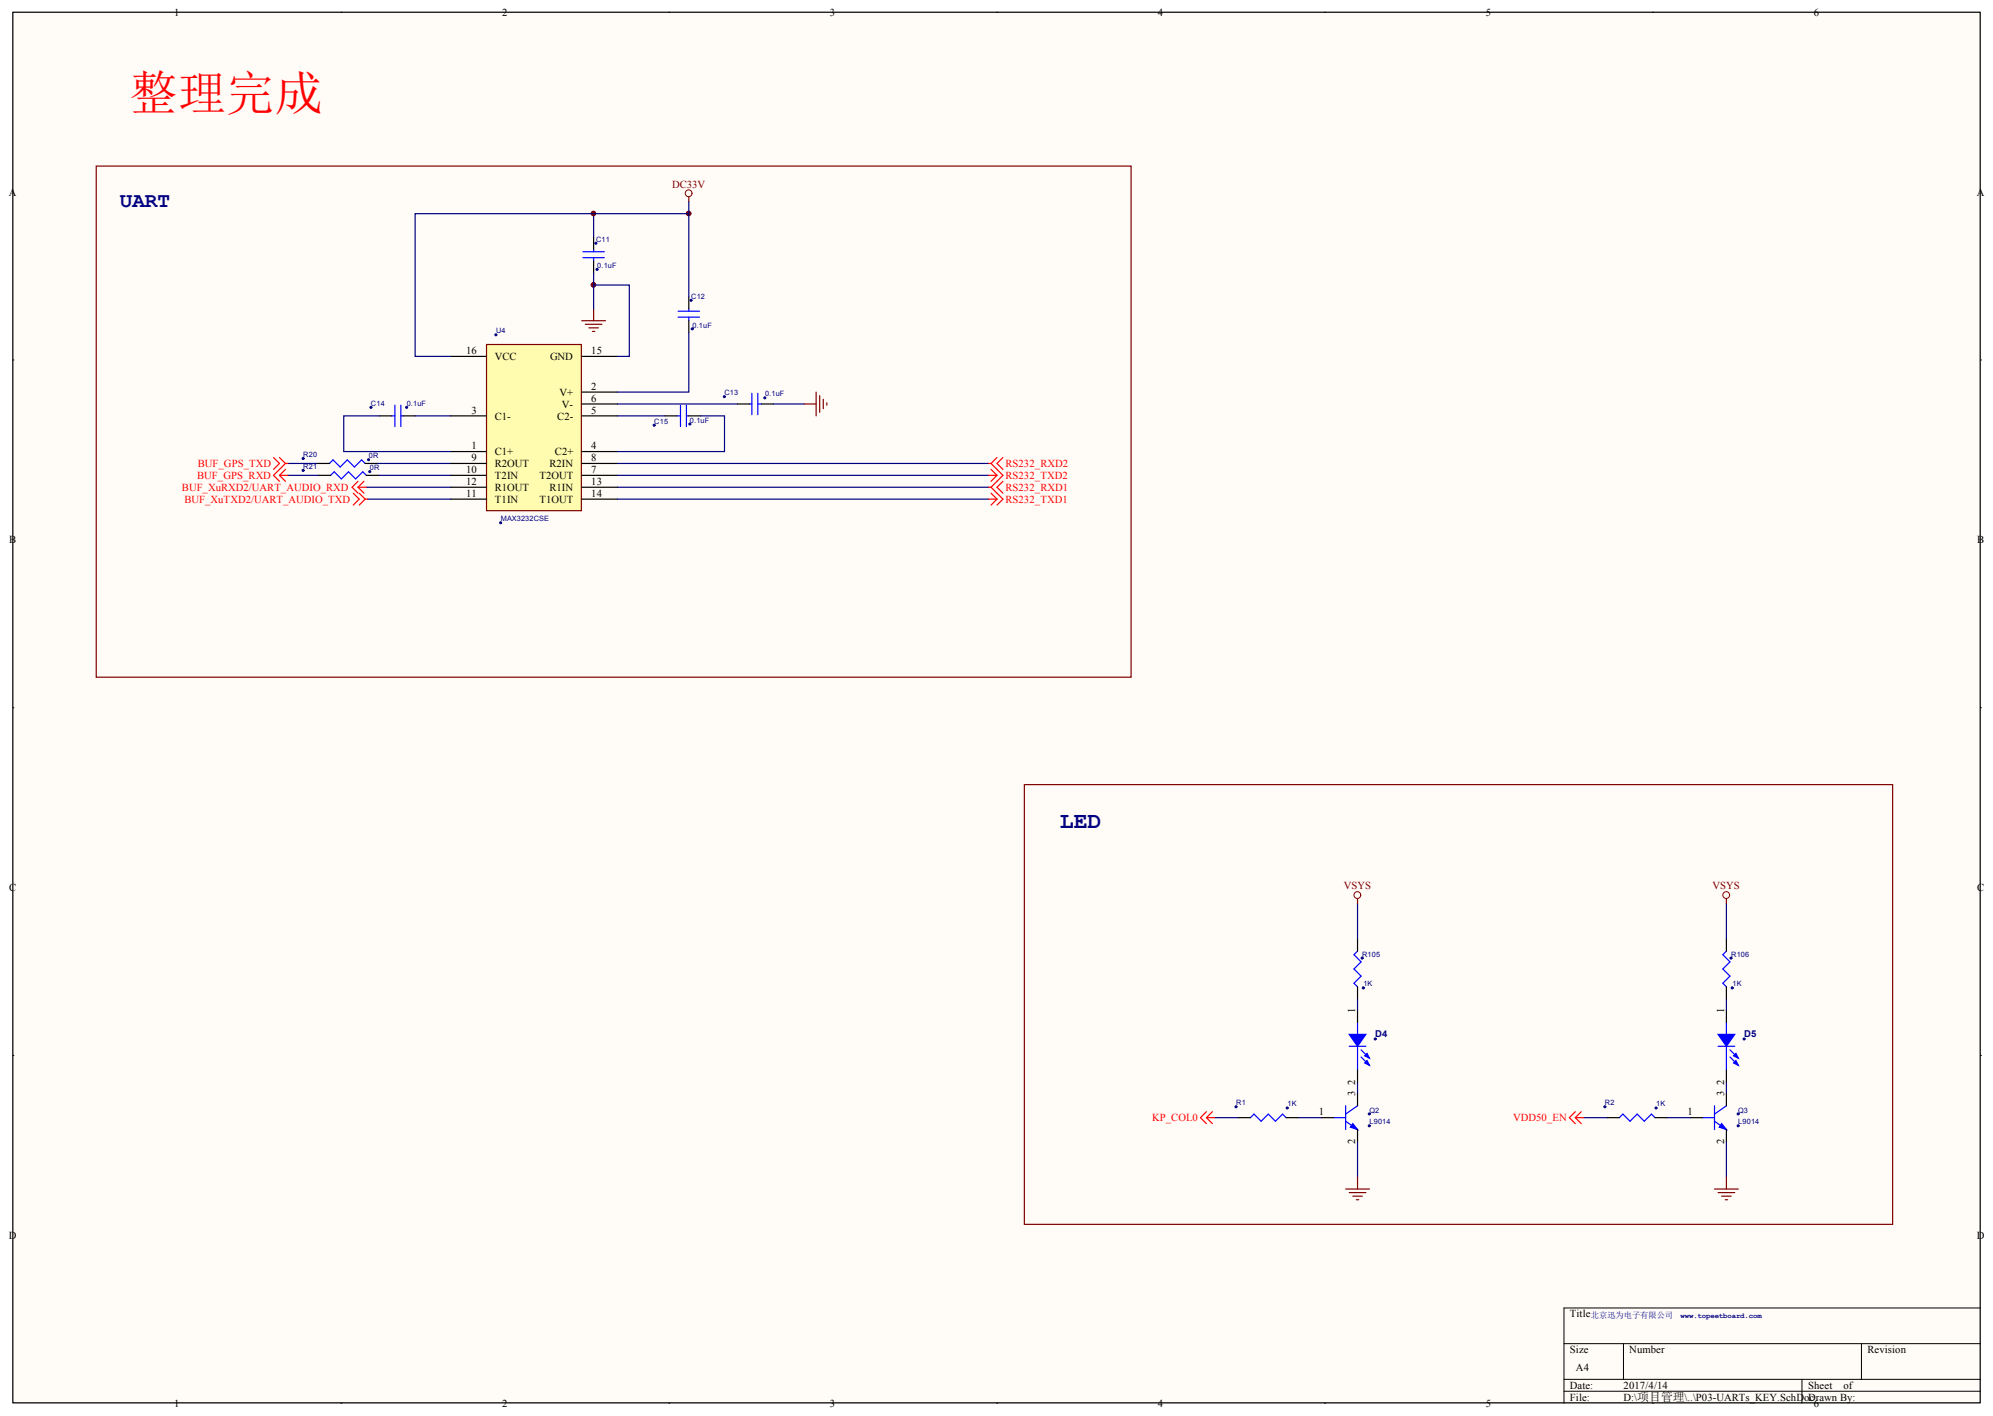
[picture p46: page 3]

北京迅为电子有限公司 www.topeetboard.com

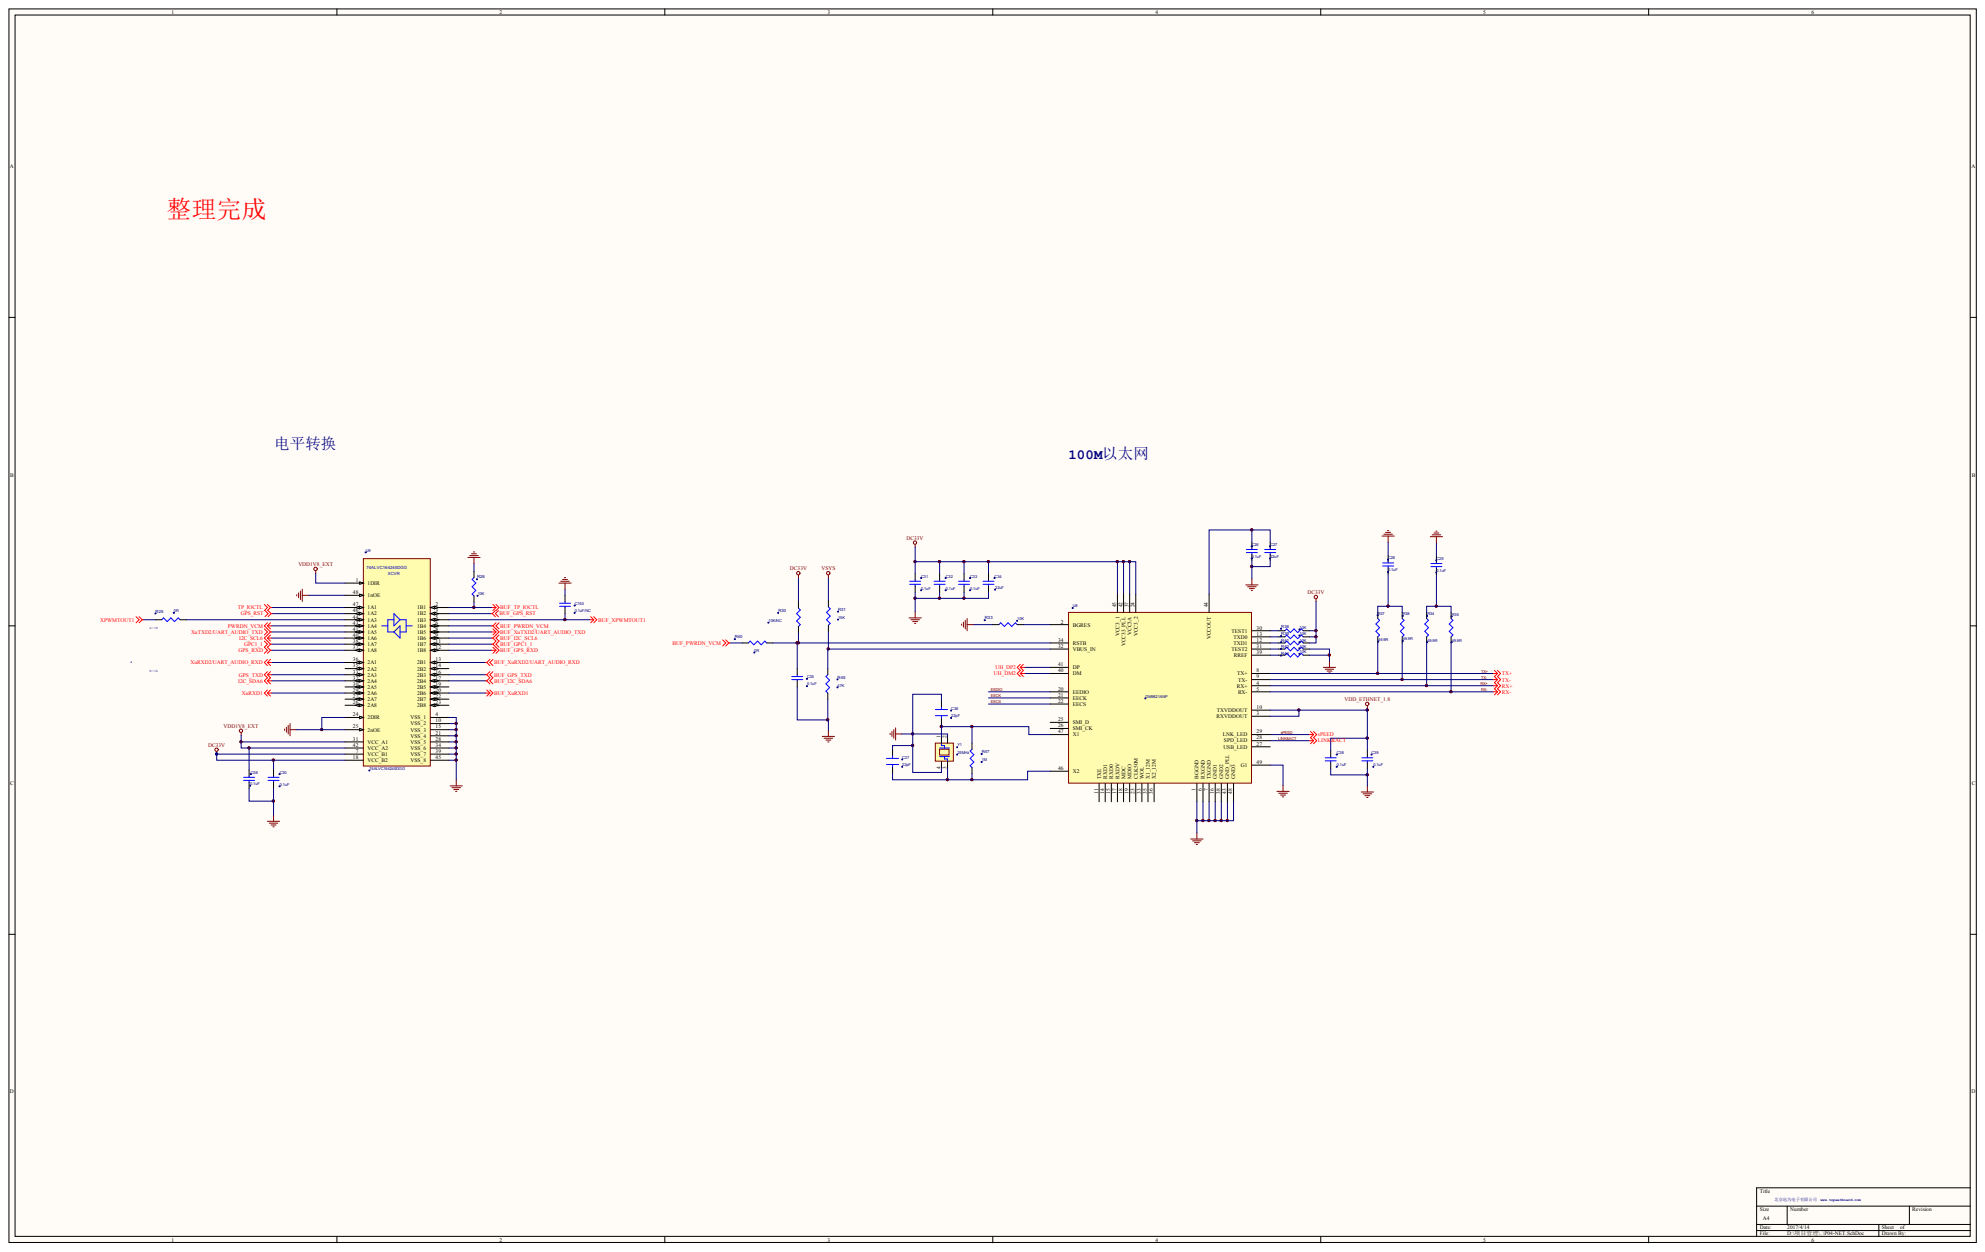
[picture p47: page 4]

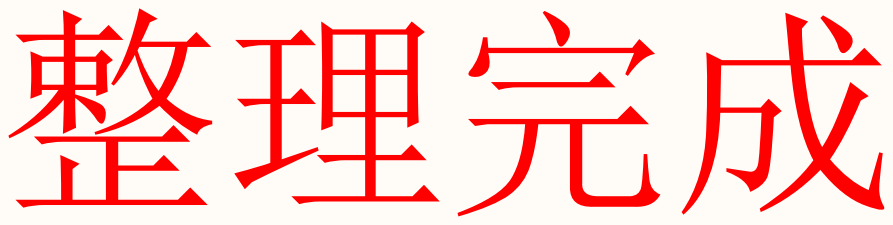
[picture p48: page 5]

北京迅为电子有限公司 www.topeetboard.com

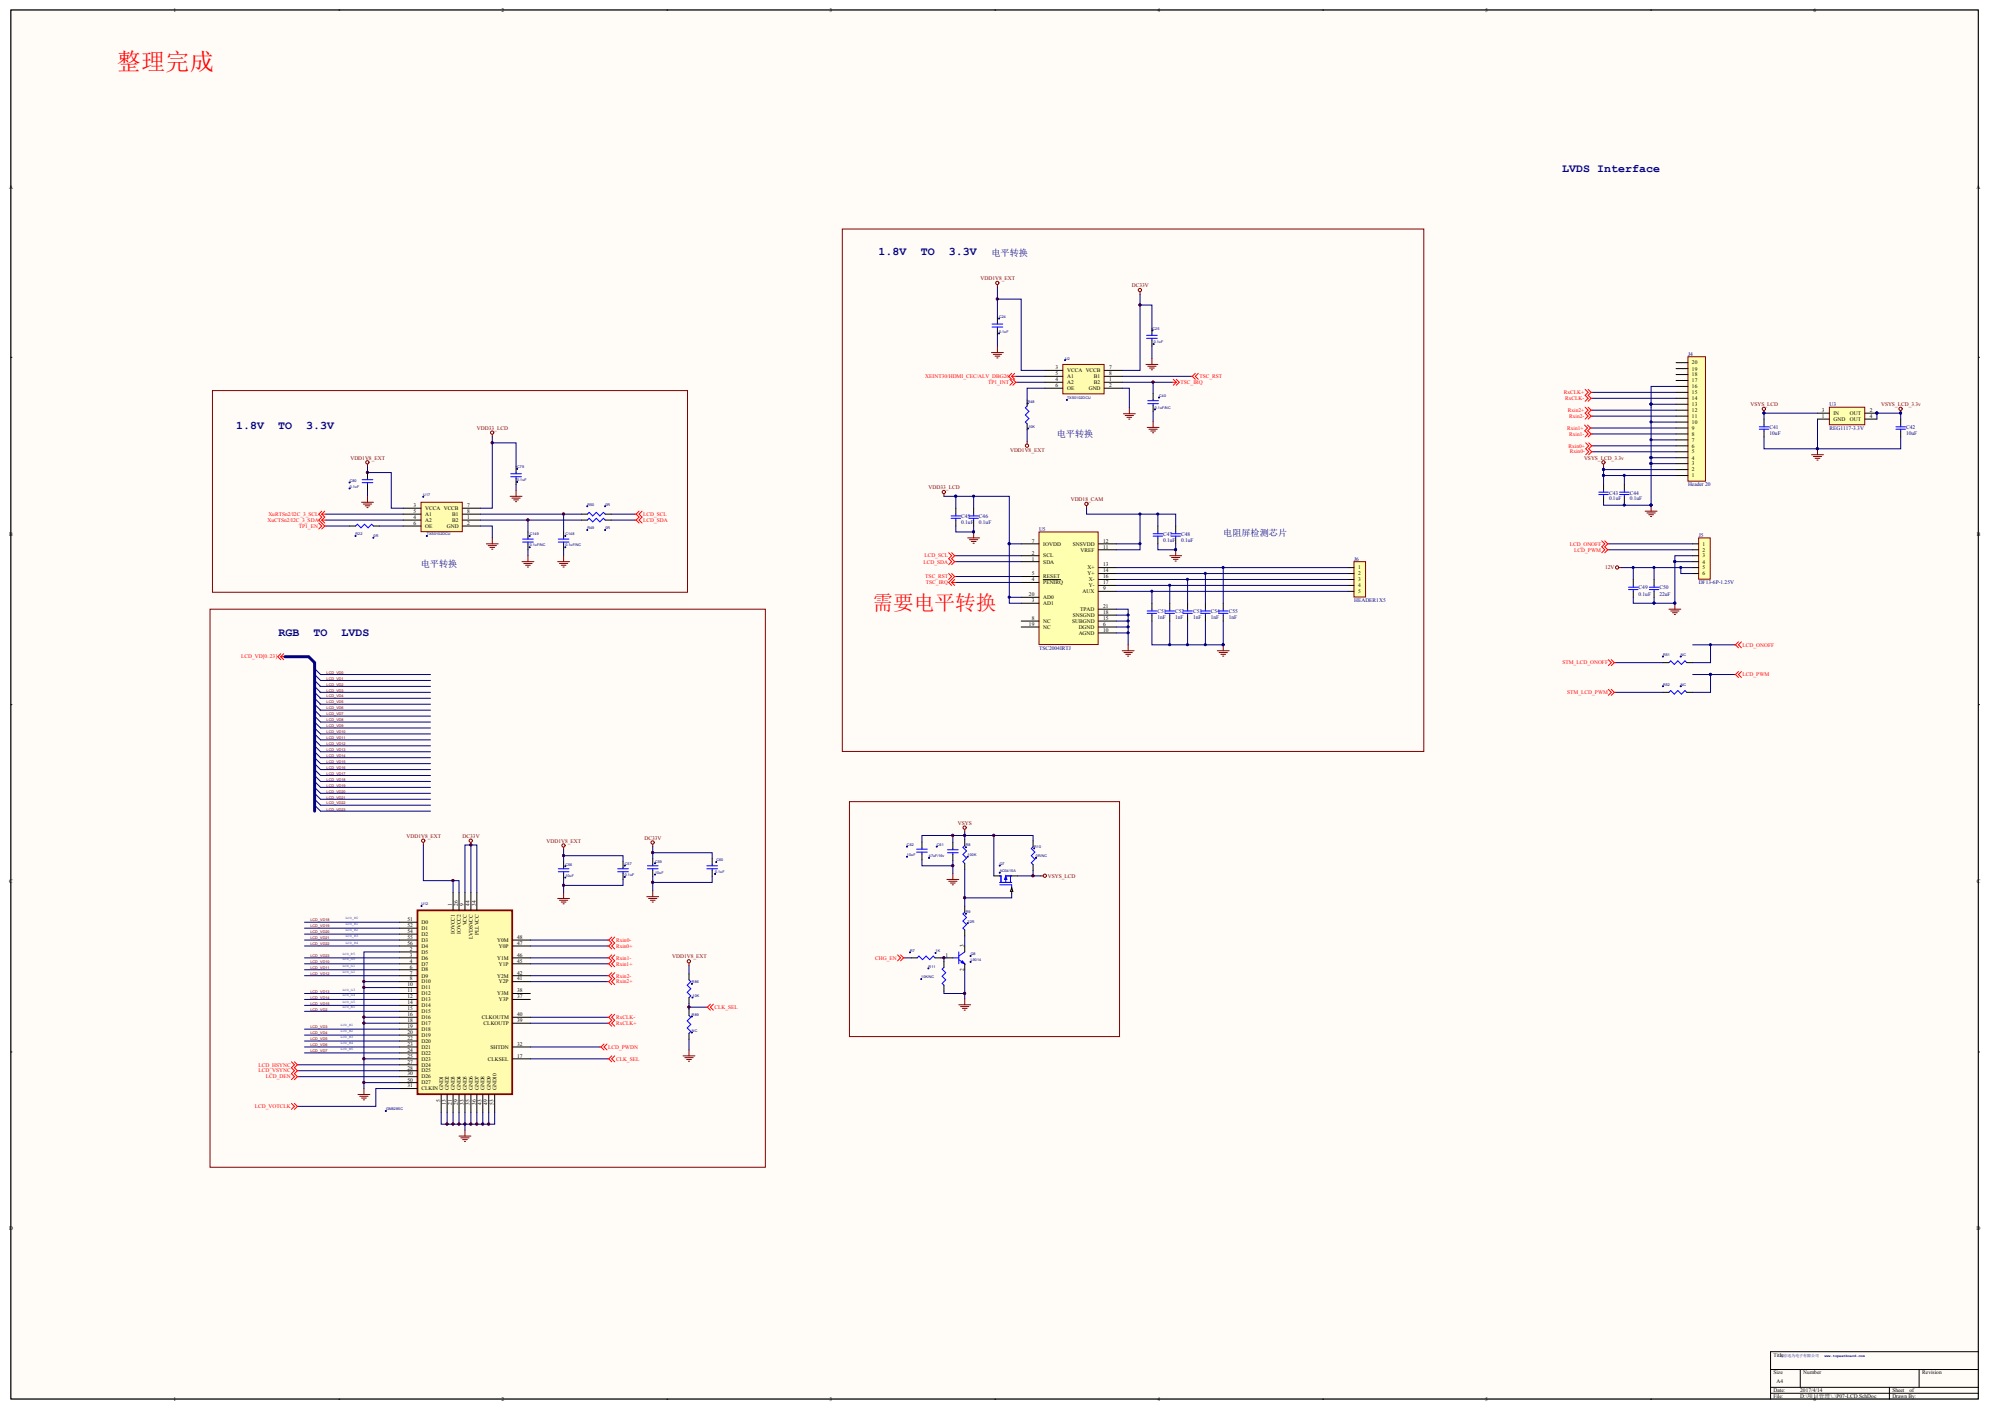
[picture p49: page 6]

D27 50 D26 30 CLKIN 31

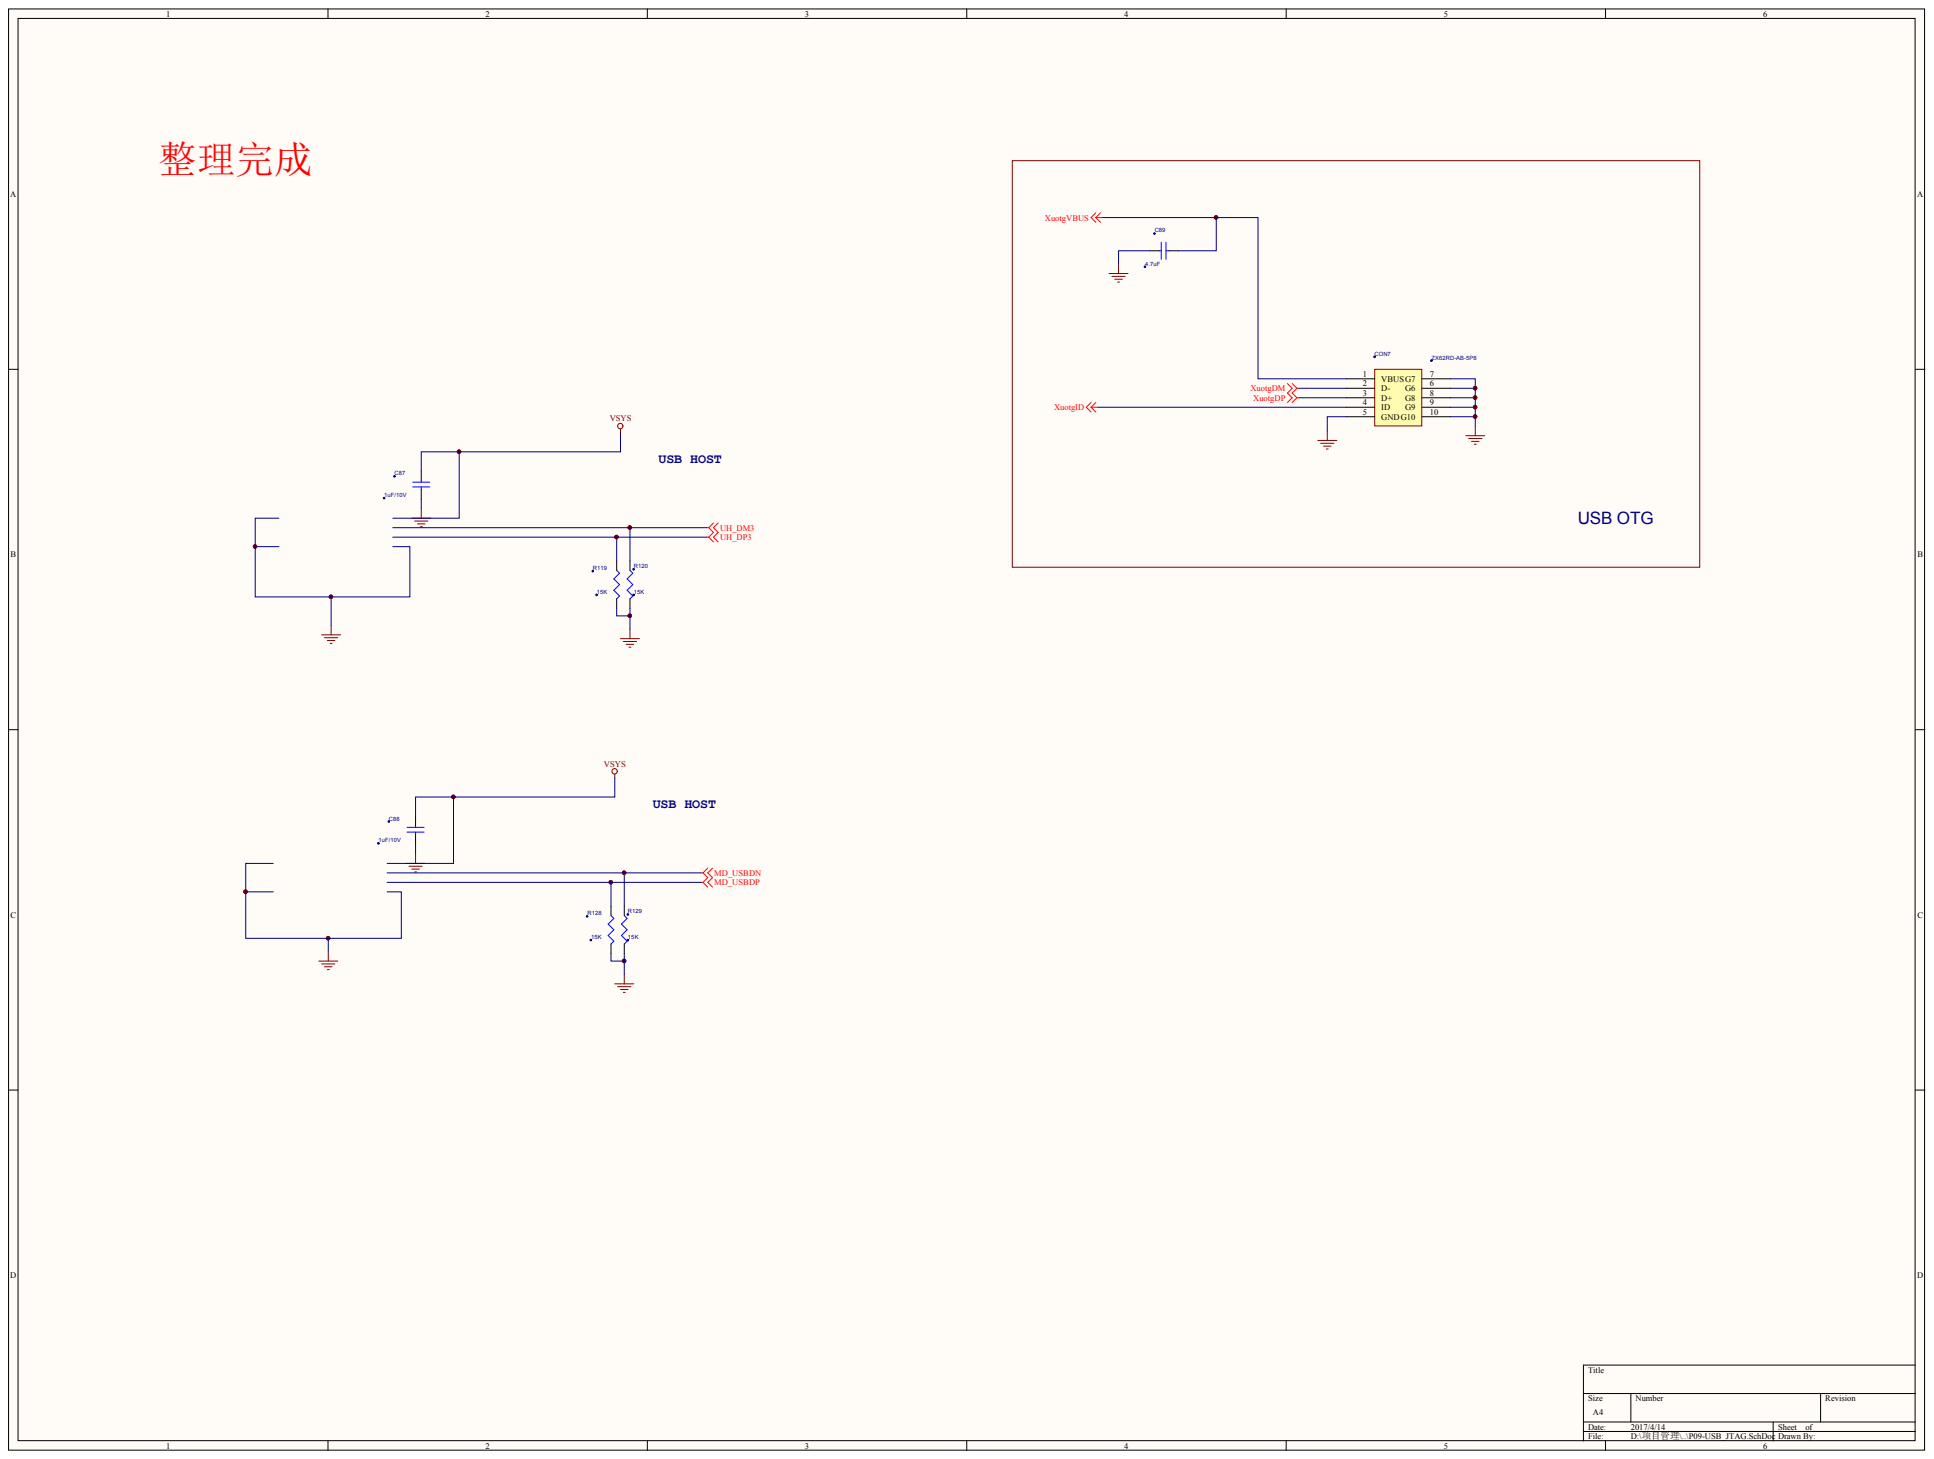
[picture p50: page 7]

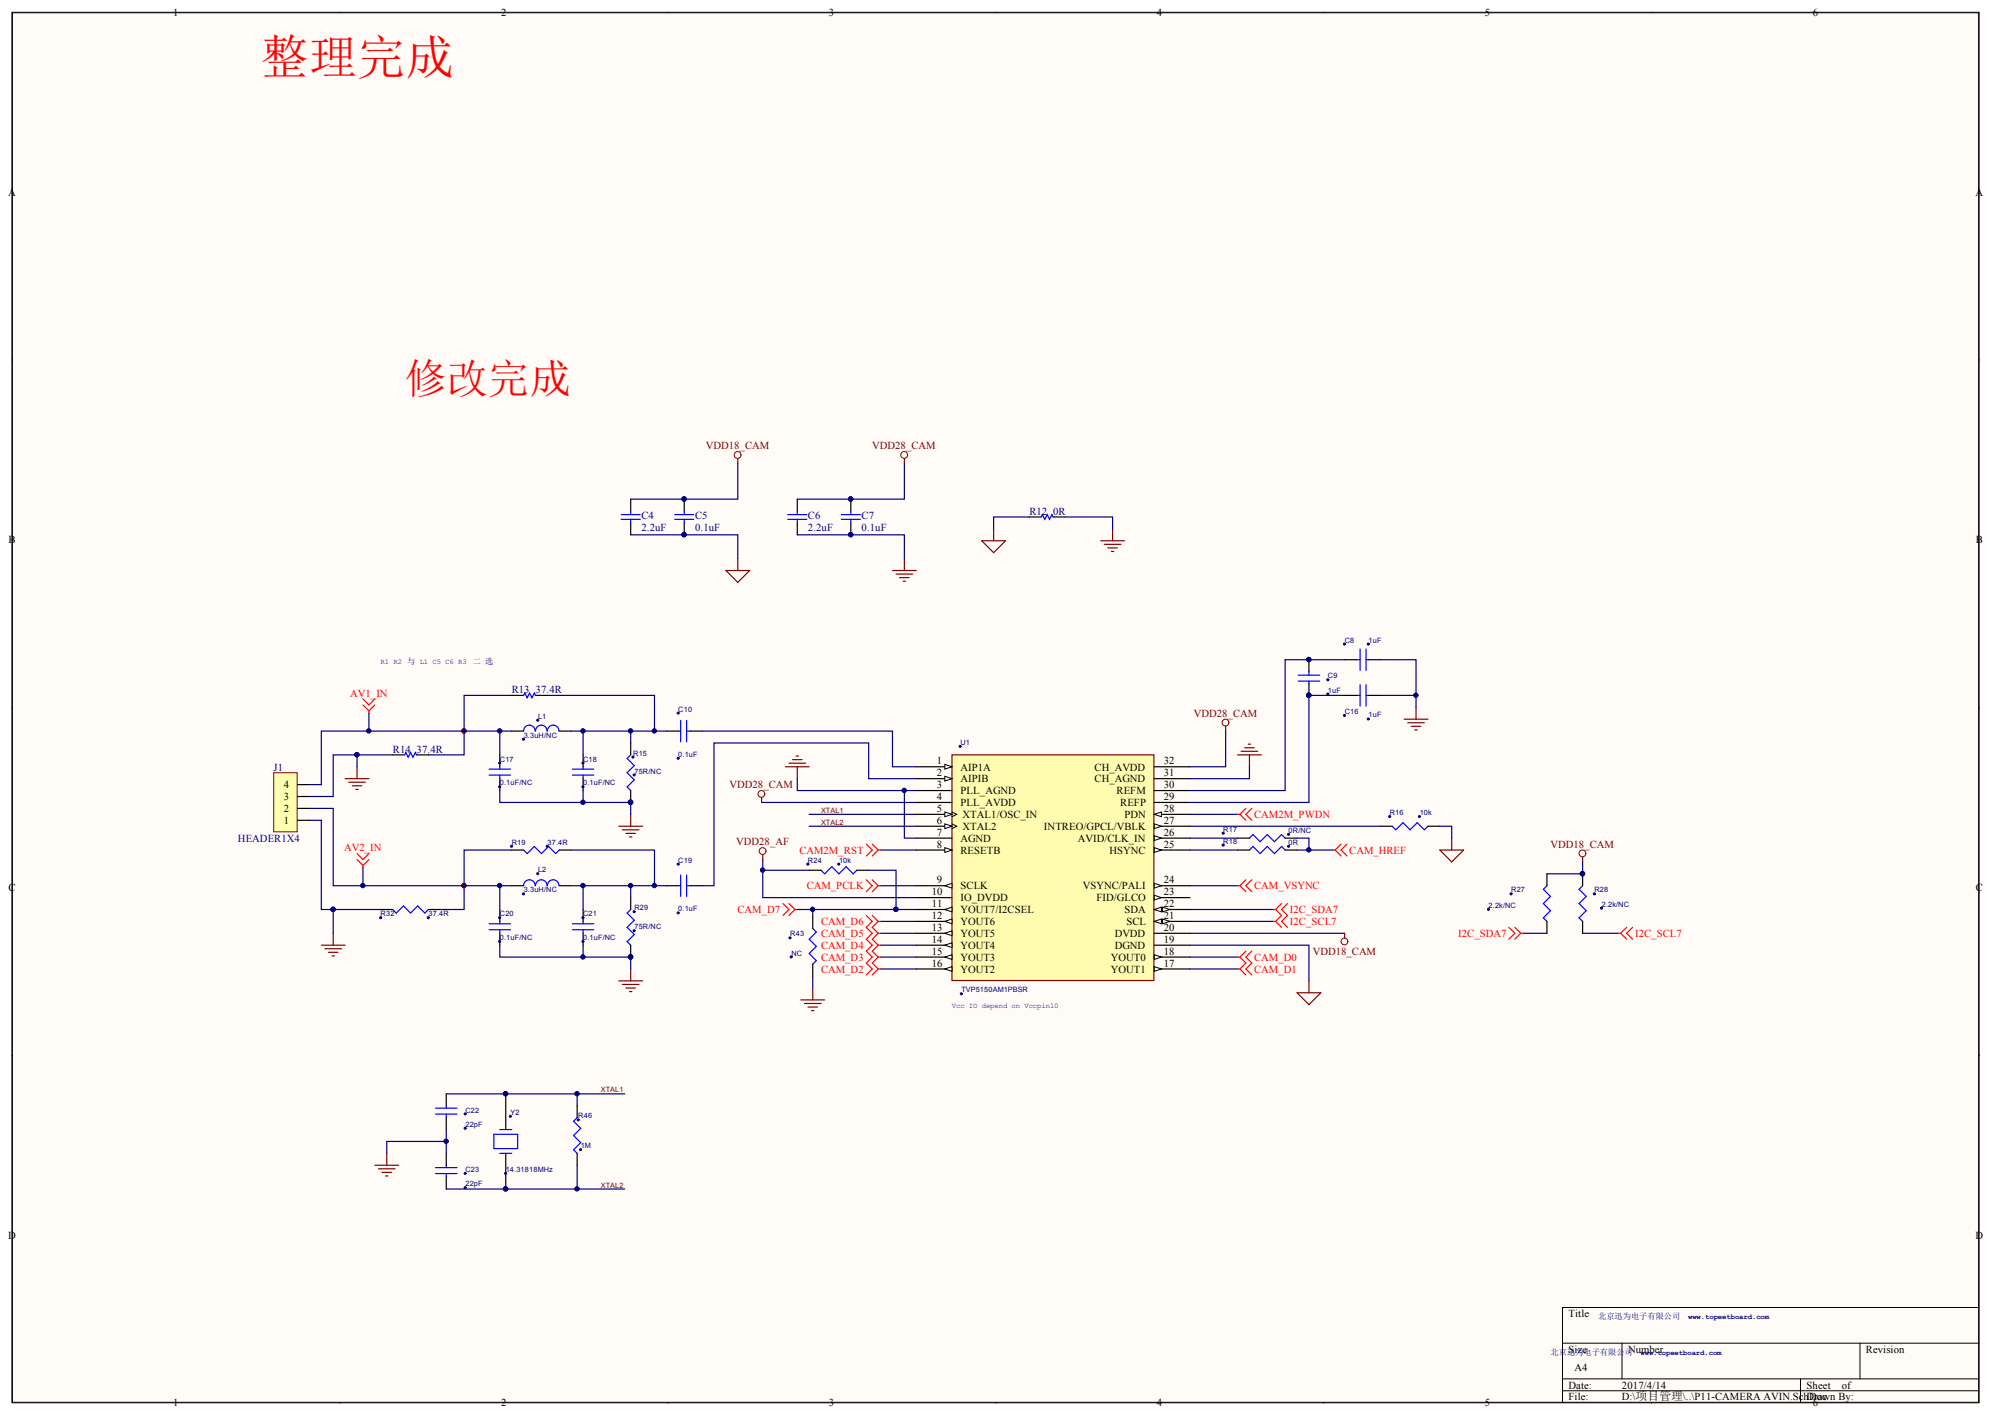
[picture p51: page 8]

CAM_ PCL K

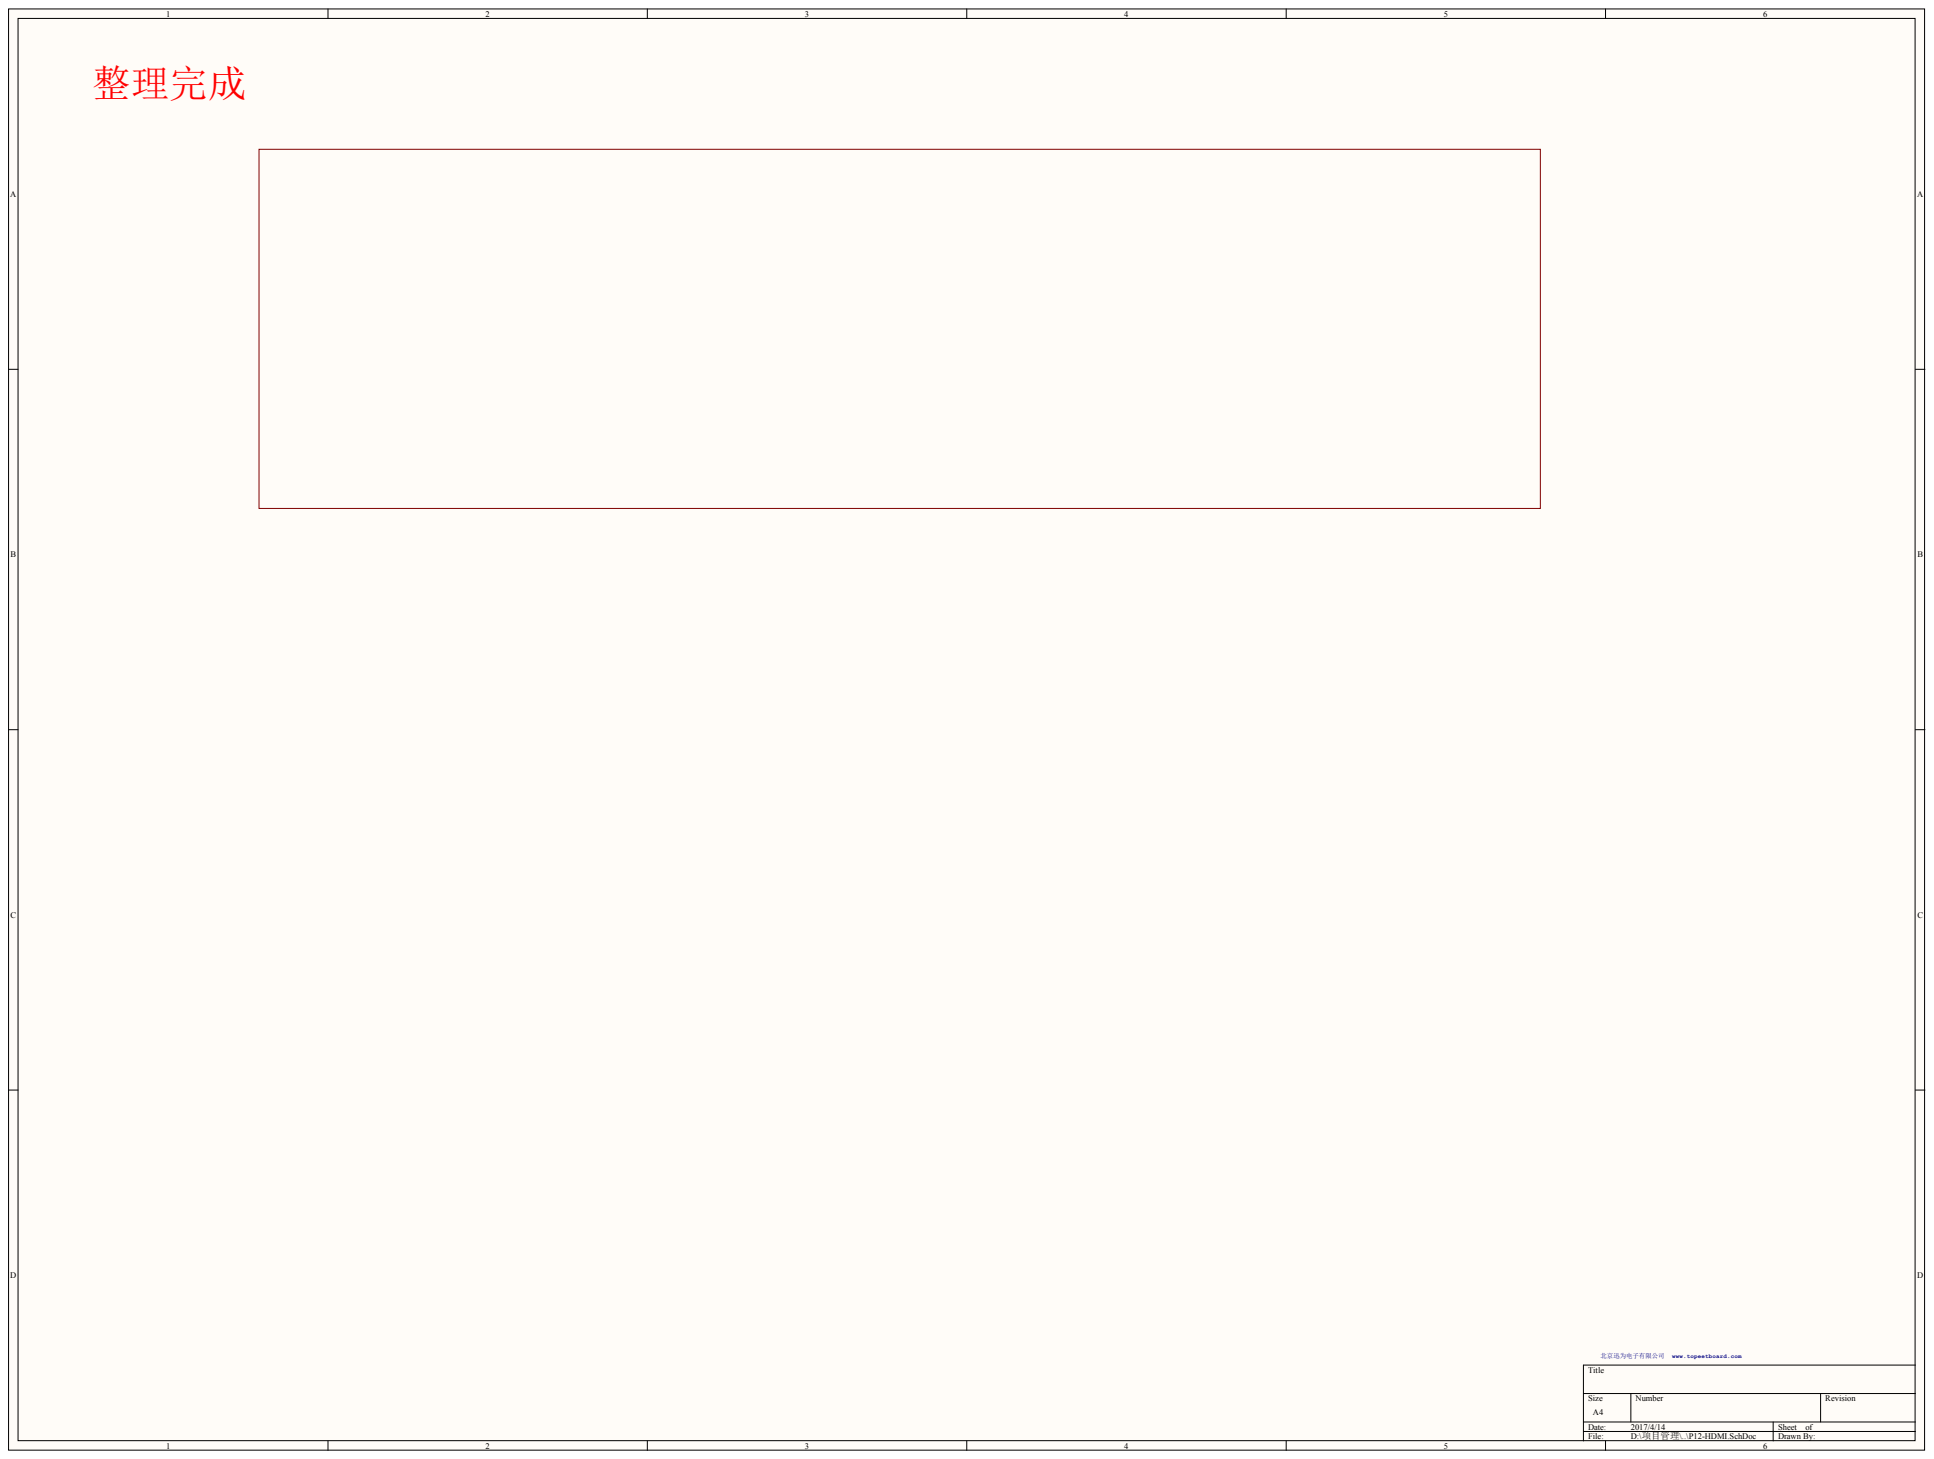
[picture p52: page 9]

北京迅为电子有限公司 www.topeetboard.com
Title

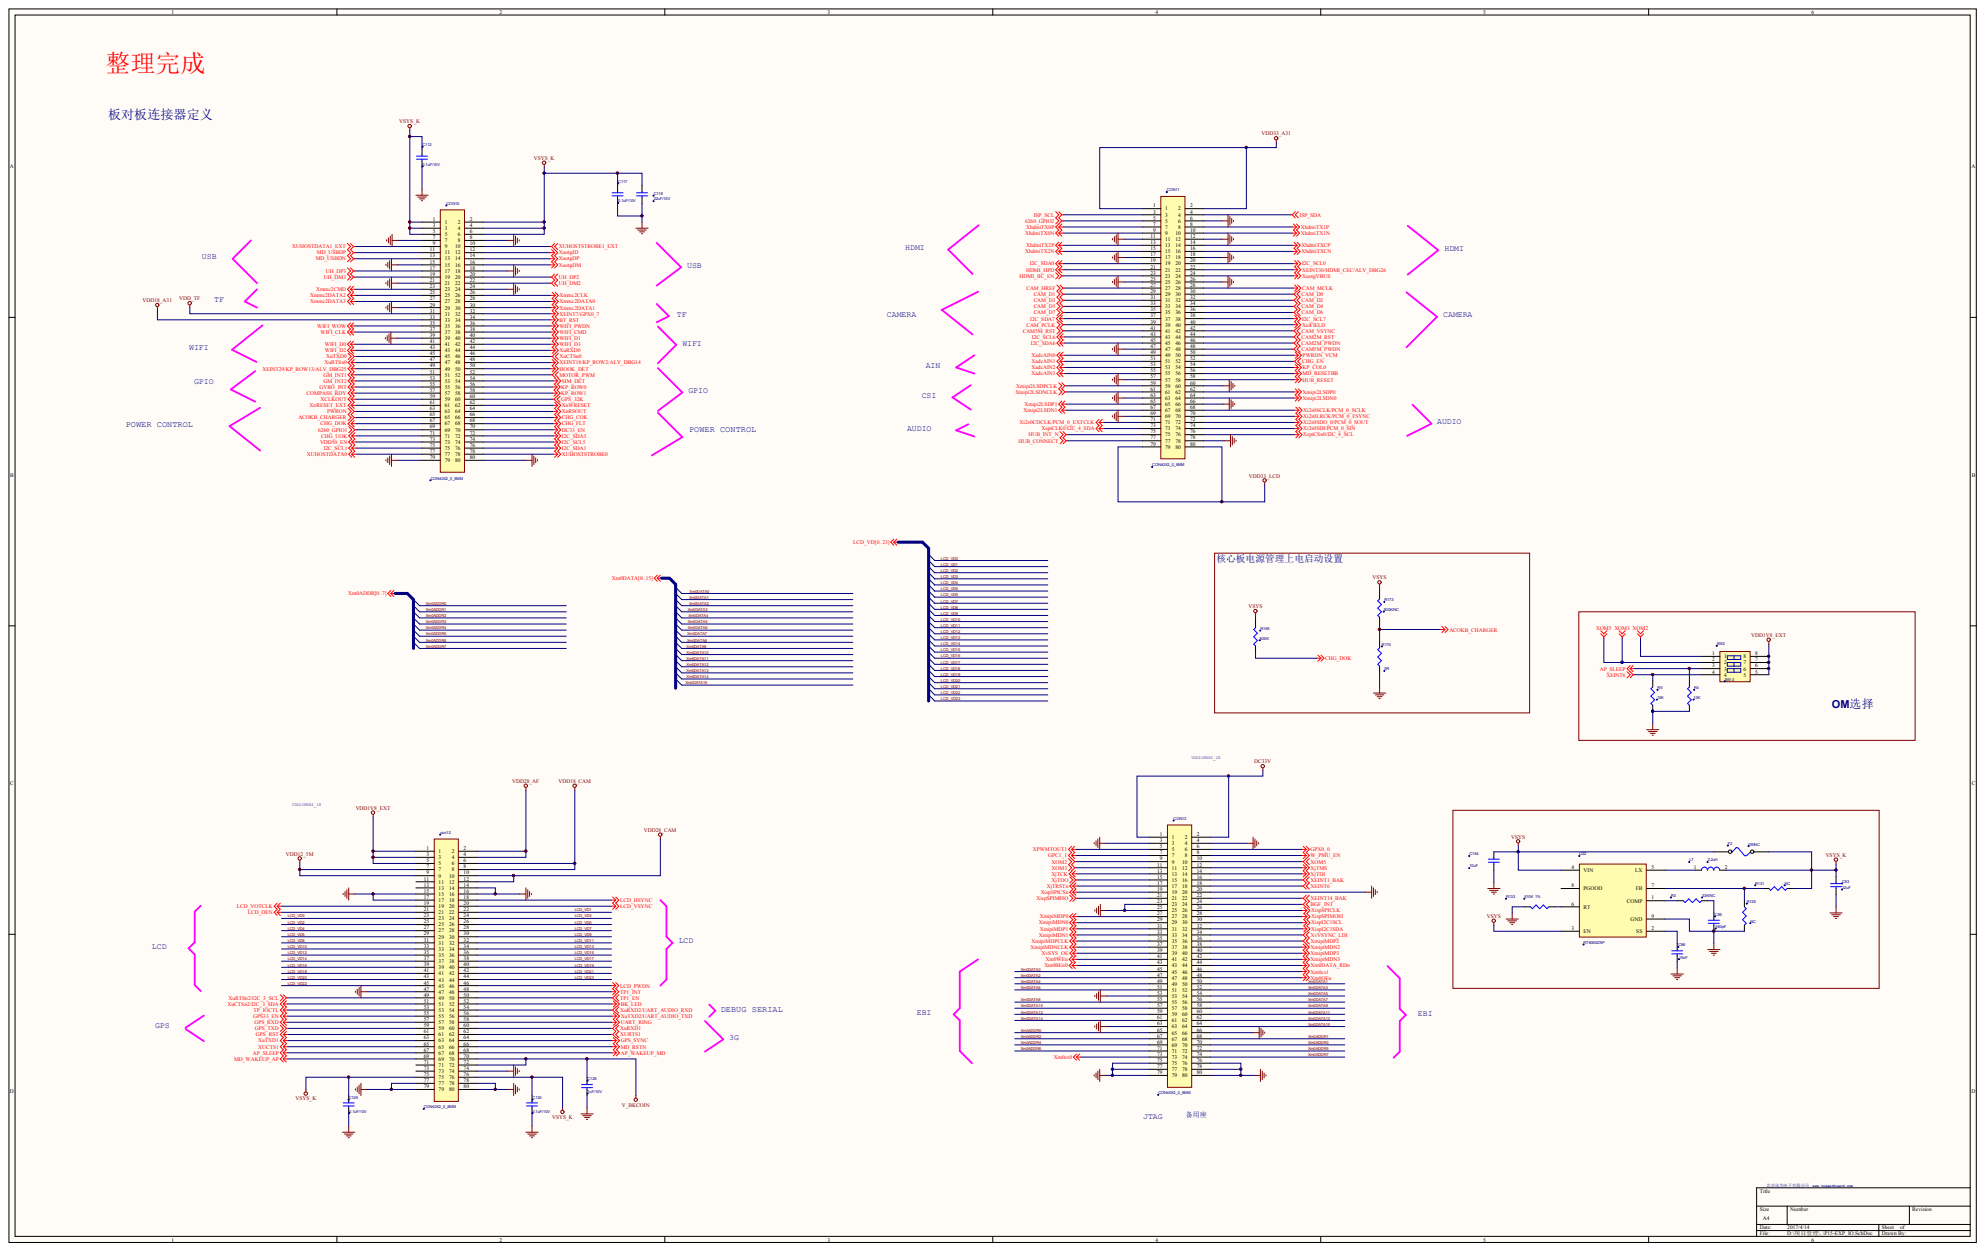
[picture p53: page 10]

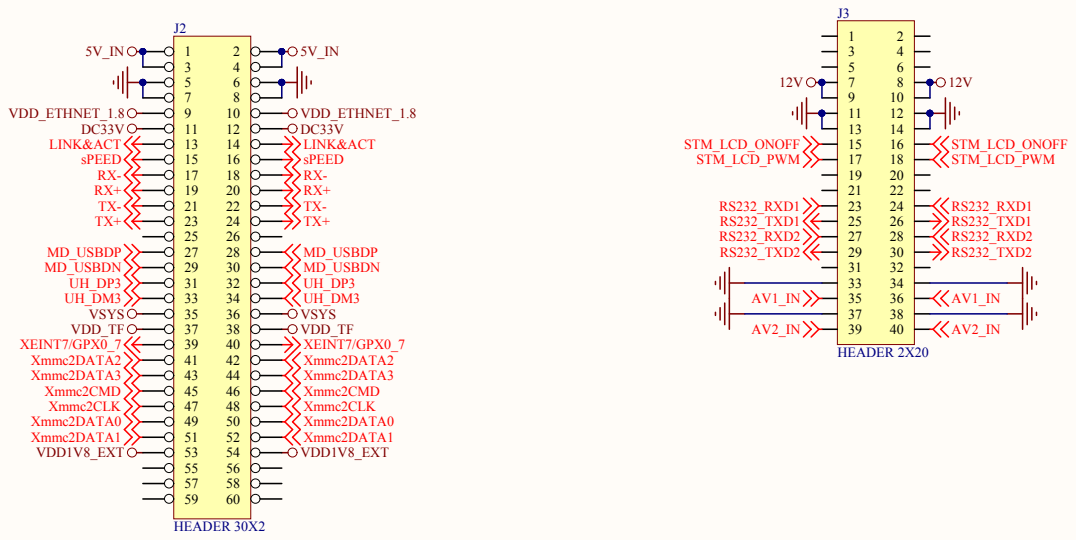
[picture p54: page 11]

Siz e A4 | Numbe r | Revision

Date : 2017/4/14 | She et of
File : D:\项目管理\..\P16-Conne ctor.SchDoc | Drawn By:

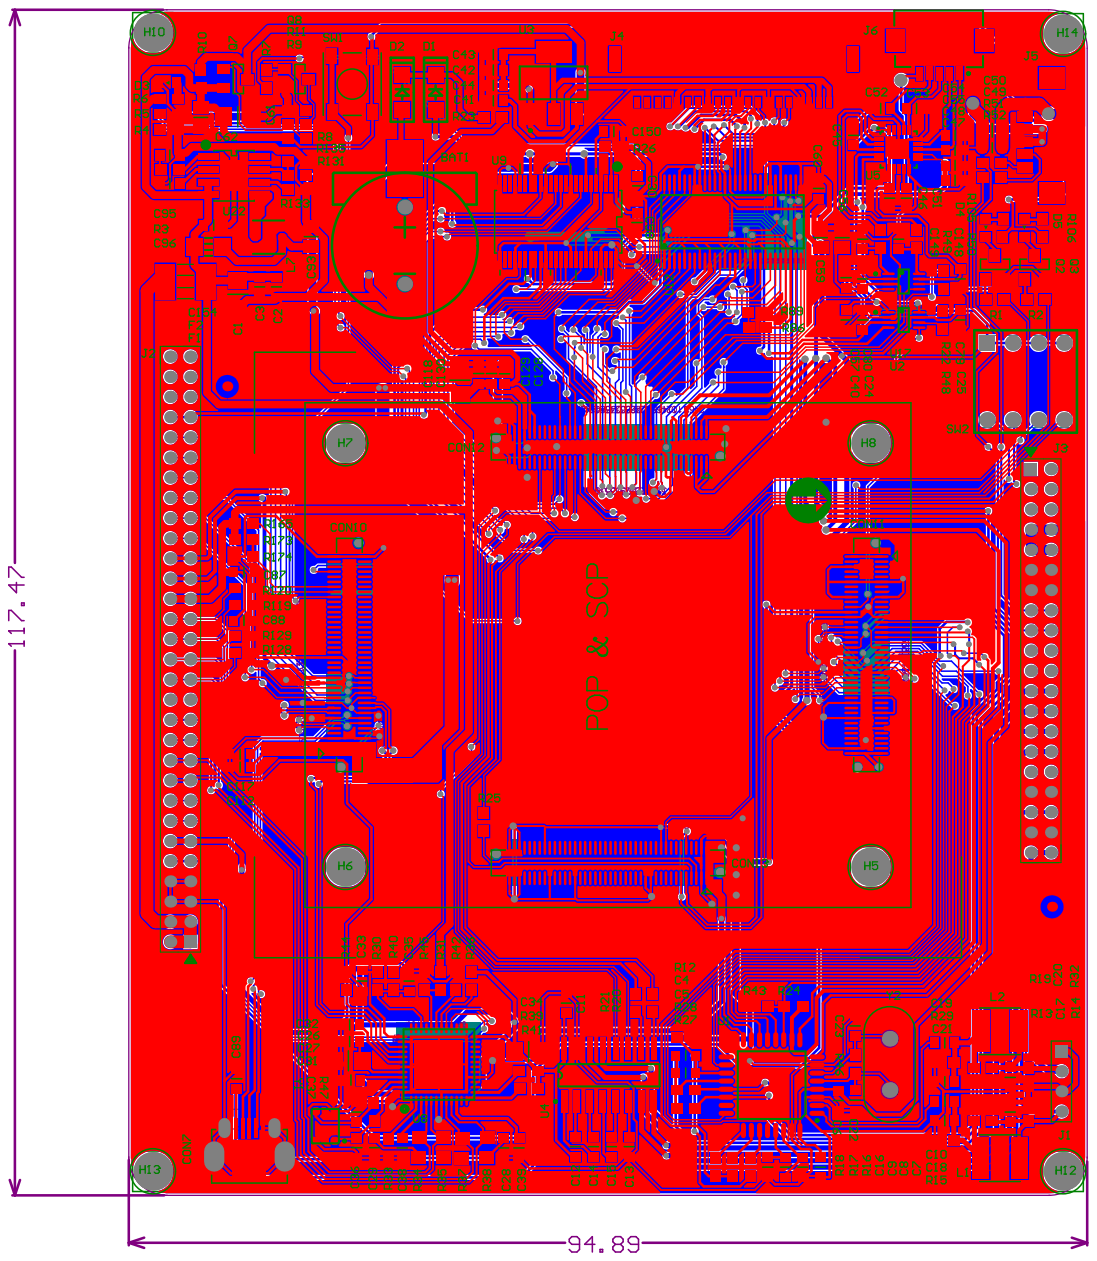
[picture p55: page 12]

Comment | Description | Designator | Footprint | LibRef | Quantity
CR1220 | | BAT1 | BAT1 | BATTERY_0 | | 1
100uF/10V | | C1 | C1206-S | CT2012_0 | | 1
0.1uF/10V | | C2, C112, C117, C129, C130 | C0603-S | C1608_Dup1, C0402_0, C0402_0, C0402_0, C0402_0
10uF/10V | | C3 | C0603-S | C1608_Dup1 | | 1
2.2uF | | C4, C6 | C0603-S | Cap Semi | | 2
0.1uF | [NoValue], [NoValue], [NoValue], [NoValue], [NoValue], [NoValue], [NoValue], [NoValue], [NoValue], [NoValue], [NoValue], [NoValue], [NoValue], [NoValue], [NoValue], [NoValue], [NoValue], [NoValue], [NoValue], [NoValue], [NoValue], CAP, CAP, [NoValue], [NoValue], [NoValue], [NoValue], CAP, [NoValue], [NoValue], [NoValue], [NoValue], [NoValue] | C5, C7, C10, C11, C12, C13, C14, C15, C19, C24, C25, C26, C28, C29, C30, C31, C32, C33, C35, C38, C39, C43, C44, C45, C46, C47, C48, C49, C57, C58, C60, C79, C80 | C0603-S | Cap Semi, Cap Semi, C0603_0, C0603_0, C0603_0, C0603_0, C0603_0, C0603_0, C0603_0, C0603_0, C0603_0, C1608_Dup1, C1608_Dup1, C1608_Dup1, C1608_Dup1, C1608_Dup1, C1608_Dup1, C1608_Dup1, C1608_Dup1, C1608_Dup1, C1608_Dup1, CAP, CAP, Cap Semi, Cap Semi, Cap Semi, Cap Semi, CAP, C0402_0, C0402_0, C0402_0, C0603_0, C0603_0 | 33
1uF | | C8, C9, C16 | C0603-S | C0603_0 | | 3
0.1uF/NC | | C17, C18, C20, C21, C40, C148, C149, C150 | C0603-S | C0603_0, C0603_0, C0603_0, C0603_0, C0603_0, C0402_0, C0402_0, C1608_Dup1 | | 8
22pF | | C22, C23, C36, C37 | C0603-s | C1005, C1005, CAP_1, CAP_1 | | 4
22uF | | C27, C34 | C1206-S | C1206_0 | | 2
10uF | CAP, CAP, CER CHIP 1U 10% X5R 0402 10V L/F | C41, C42, C154 | C0603-s | CAP, CAP, CAP NP_3 | | 3
22uF | CAP, [NoValue] | C50, C93 | C0805-s | CAP, C1005 | | 2
1nF | | C51, C52, C53, C54, C55 | C0603-S | Cap Semi | | 5
10uF | | C56, C59, C62 | C0805-S | C1608_Dup2 | | 3
47uF/16v | | C61 | C1206-S | C1608_Dup2 | | 1
1uF/10V | | C87, C88, C128 | C0603-S | C0603_0 | | 3
4.7uF | | C89 | C0603-S | C1005 | | 1
560pF | CER CHIP 1U 10% X5R 0402 10V L/F | C95 | C0603-S | CAP NP_3 | | 1
10nF | CER CHIP 1U 10% X5R 0402 10V L/F | C96 | C0603-S | CAP NP_3 | | 1
22uF/10V | | C118 | C1206-S | C1206_0 | | 1
ZX62RD-AB-5P8 | | CON7 | MICROUSB-B-H4 | ZX62RD-AB-5P8_3 | | 1
CON40X2_0_8MM | | CON10, CON11, con12, CON13 | CON2X40-0_5MM-BB | CON40X2_0_8MM | | 4
IN4148 | | D1, D2 | D1206 | DIODE | | 2
LED-Red (SMD 2012) | | D3, D4, D5 | LED0603 | LED-RED_SMD_1 | | 3
500ma | | F1 | F1812 | FUSE | | 1
0R/NC | | F2 | F1206 | FUSE | | 1
TP_P0_0.8_D0 | | H5, H6, H7, H8, H10, H12, H13, H14 | HOLE2_7 | TP_P0_0.8_D0 | | 8
HEADER1X4 | | J1 | HD1X4-2.00 | HEADER1X4 | | 1
HEADER 30X2 | | J2 | HD2X30-2.00 | HEADER 30X2 | | 1
HEADER 2X20 | | J3 | HD2X20-2.00 | HEADER 2X20 | | 1
Header 20 | Header, 20-Pin | J4 | DF19G-20P | Header 20 | | 1
DF13-6P-1.25V | | J5 | DF13-6P-1.25V | HEADER1X6 | | 1
HEADER1X5 | | J6 | FFC/SM1.0-5 | HEADER1X5 | | 1
3.3uH/NC | | L1, L2 | L4X4-S | LQH32C_0 | | 2
2.2uH | | L7 | L3X3MM | LQH32C_0 | | 1
L9014 | | Q2, Q3, Q8 | SOT-23 | L14P2/TO_1 | | 3
AO3415A | | Q7 | SOT-23 | MOSFET P | | 1
1K | | R1, R2, R7, R105, R106 | R0603-S | R1005_0_Dup1 | | 5
33K/NC | | R3 | R0603-S | R1005_0 | | 1
10K | | R4, R5, R6, R16, R24, R26, R33, R36, R39, R41, R42, R44, R48, R86 | R0603-S | R1005_0_Dup1, R1005_0_Dup1, R1005_0_Dup1, R1005_0, R1005_0, RESISTOR_0, RESISTOR_0, RESISTOR_0, RESISTOR_0, RESISTOR_0, RESISTOR_0, RESISTOR_0, R0603_0, R1005_0_Dup1 | 14
100K | | R8 | R0603-S | R1005_0_Dup1 | | 1
22R | | R9 | R0603-S | R1005_0_Dup1 | | 1
0R/NC | | R10, R17 | R0603-S | R1005_0_Dup1, R1005_0 | | 2
10K/NC | | R11, R30 | R0603-S | R1005_0_Dup1, RESISTOR_0 | | 2
0R | | R12, R18, R20, R21, R22, R23, R25, R40, R49, R50, R174 | R0603-S | Res, R1005_0, R1005_0, R1005_0, R1005_0_Dup1, R, RESISTOR_0, RESISTOR_0, R1005_0_Dup1, R1005_0_Dup1, R1005_0_Dup1 | 11
37.4R | | R13, R14, R19, R32 | R0603-S | Res, Res, R1005_0, R1005_0 | | 4
75R/NC | | R15, R29 | R0603-S | R1005_0 | | 2
2.2k/NC | | R27, R28 | R0603-S | R1005_0 | | 2
15K | | R31, R119, R120, R128, R129 | R0603-S | RESISTOR_0, R1005_0, R1005_0, R1005_0, R1005_0 | | 5
49.9R | | R34, R35, R37, R38 | R0805-S | R_Dup2 | | 4
NC | | R43, R51, R52, R89, R131, R135 | R0603-S | R1005_0, R1005_0_Dup1, R1005_0_Dup1, R1005_0_Dup1, R1005_0, R1005_0 | | 6
47K | | R45 | R0603-S | RESISTOR_0 | | 1
1M | | R46, R47 | R0603-S | R1005_0, RESISTOR_0 | | 2
510K 1% | | R133 | R0603-S | R1005_0 | | 1
800K | | R165 | R0603-S | R1005_0_Dup1 | | 1
800K/NC | | R173 | R0603-S | R1005_0_Dup1 | | 1
RESET | | SW1 | SW4-SMD | SW-4 | | 1
SW-3 | | SW2 | bmkg4 | SW-3_1 | | 1
TVP5150AM1PBSR | | U1 | QFP7X7-32 | TVP5151 | | 1
TXS0102DCU | | U2, U17 | tssop8 | TXS0102DCU_1 | | 2
REG1117-3.3V | 800mA and 1A Low Dropout Positive Regulator 2.85V, 3.3V, 5V, and Adjustable | U3 | SOT-223 | REG1117-3.3 | | 1
MAX3232CSE | | U4 | SO-16 | MAX3232EEAE | | 1
TSC2004IRTJ | Current Sensor | U5 | QFN20 | TSC2004IRTJ | | 1
DM9621ANP | | U8 | QFN48-050-0707LH | DM9621NP_1 | | 1
U-74ALVC164245DGG | | U9 | TSSOP_48 | U-74ALVC164245DGG | | 1
GM8285C | | U12 | TSSOP56 | U-SN75LVDS83BDGG_3 | | 1
RT8065ZSP | | U22 | soic8-lh | RT8065_3 | | 1
25MHz | | Y1 | X4-2_5X3_2 | Y_24.576MHZ-5032 | | 1
14.31818MHz | | Y2 | CRYSTAL_D200 | XM/SM | | 1
