wuxinyou/05-XBotHighCtrlBox/(list of files, drawings)

Other design files:
02-核心板/电气设计/CT310高端控制盒核心板电路V1.2/CT310高端控制盒核心板电路V1.2.PcbDoc
02-核心板/电气设计/CT310高端控制盒核心板电路V1.2/CT310高端控制盒核心板电路V1.2.PRJPCB
02-核心板/电气设计/CT310高端控制盒核心板电路V1.2/iTOP4412_main_Clasics_v3_2.PcbLib
02-核心板/电气设计/CT310高端控制盒核心板电路V1.2/iTOP4412_main_Clasics_v3_2.SCHLIB
02-核心板/电气设计/CT310高端控制盒核心板电路V1.2/P01.SchDoc
02-核心板/电气设计/CT310高端控制盒核心板电路V1.2/P02-DC_JACK.SchDoc
02-核心板/电气设计/CT310高端控制盒核心板电路V1.2/P03-UARTs_KEY.SchDoc
02-核心板/电气设计/CT310高端控制盒核心板电路V1.2/P04-NET.SchDoc
02-核心板/电气设计/CT310高端控制盒核心板电路V1.2/P05-SD_WIFI.SchDoc
02-核心板/电气设计/CT310高端控制盒核心板电路V1.2/P06-Audio.SchDoc
02-核心板/电气设计/CT310高端控制盒核心板电路V1.2/P07-LCD.SchDoc
02-核心板/电气设计/CT310高端控制盒核心板电路V1.2/P09-USB_JTAG.SchDoc
02-核心板/电气设计/CT310高端控制盒核心板电路V1.2/P11-CAMERA AVIN.SchDoc
02-核心板/电气设计/CT310高端控制盒核心板电路V1.2/P12-HDMI.SchDoc
02-核心板/电气设计/CT310高端控制盒核心板电路V1.2/P15-EXP_IO.SchDoc
02-核心板/电气设计/CT310高端控制盒核心板电路V1.2/P16-Connector.SchDoc
02-核心板/电气设计/CT310高端控制盒核心板电路V1.3/CT310高端控制盒核心板电路V1.3.PcbDoc
02-核心板/电气设计/CT310高端控制盒核心板电路V1.3/CT310高端控制盒核心板电路V1.3.PRJPCB
02-核心板/电气设计/CT310高端控制盒核心板电路V1.3/iTOP4412_main_Clasics_v3_2.PcbLib
02-核心板/电气设计/CT310高端控制盒核心板电路V1.3/iTOP4412_main_Clasics_v3_2.SCHLIB
02-核心板/电气设计/CT310高端控制盒核心板电路V1.3/P01.SchDoc
02-核心板/电气设计/CT310高端控制盒核心板电路V1.3/P02-DC_JACK.SchDoc
02-核心板/电气设计/CT310高端控制盒核心板电路V1.3/P03-UARTs_KEY.SchDoc
02-核心板/电气设计/CT310高端控制盒核心板电路V1.3/P04-NET.SchDoc
02-核心板/电气设计/CT310高端控制盒核心板电路V1.3/P05-SD_WIFI.SchDoc
02-核心板/电气设计/CT310高端控制盒核心板电路V1.3/P06-Audio.SchDoc
02-核心板/电气设计/CT310高端控制盒核心板电路V1.3/P07-LCD.SchDoc
02-核心板/电气设计/CT310高端控制盒核心板电路V1.3/P09-USB_JTAG.SchDoc
02-核心板/电气设计/CT310高端控制盒核心板电路V1.3/P11-CAMERA AVIN.SchDoc
02-核心板/电气设计/CT310高端控制盒核心板电路V1.3/P12-HDMI.SchDoc
02-核心板/电气设计/CT310高端控制盒核心板电路V1.3/P15-EXP_IO.SchDoc
02-核心板/电气设计/CT310高端控制盒核心板电路V1.3/P16-Connector.SchDoc
03-基板/历史/【1】高端控制器整理完成/【2】高端控制器 最终版电路板汇总/【1】XBTO高端控制盒V1.1/XBTO高端控制盒V1.1/BAT_TO_ADC.SchDoc
03-基板/历史/【1】高端控制器整理完成/【2】高端控制器 最终版电路板汇总/【1】XBTO高端控制盒V1.1/XBTO高端控制盒V1.1/FrameWork.SchDoc
03-基板/历史/【1】高端控制器整理完成/【2】高端控制器 最终版电路板汇总/【1】XBTO高端控制盒V1.1/XBTO高端控制盒V1.1/JoyStickAdcInput.SchDoc
03-基板/历史/【1】高端控制器整理完成/【2】高端控制器 最终版电路板汇总/【1】XBTO高端控制盒V1.1/XBTO高端控制盒V1.1/KeyInput_ABH.SchDoc
03-基板/历史/【1】高端控制器整理完成/【2】高端控制器 最终版电路板汇总/【1】XBTO高端控制盒V1.1/XBTO高端控制盒V1.1/KeyInput_IJMEF.SchDoc
03-基板/历史/【1】高端控制器整理完成/【2】高端控制器 最终版电路板汇总/【1】XBTO高端控制盒V1.1/XBTO高端控制盒V1.1/KeyInput_MG.SchDoc
03-基板/历史/【1】高端控制器整理完成/【2】高端控制器 最终版电路板汇总/【1】XBTO高端控制盒V1.1/XBTO高端控制盒V1.1/LeftInterface.SchDoc
03-基板/历史/【1】高端控制器整理完成/【2】高端控制器 最终版电路板汇总/【1】XBTO高端控制盒V1.1/XBTO高端控制盒V1.1/OmapSystem.SchDoc
03-基板/历史/【1】高端控制器整理完成/【2】高端控制器 最终版电路板汇总/【1】XBTO高端控制盒V1.1/XBTO高端控制盒V1.1/PowerManager.SchDoc
03-基板/历史/【1】高端控制器整理完成/【2】高端控制器 最终版电路板汇总/【1】XBTO高端控制盒V1.1/XBTO高端控制盒V1.1/Processor.SchDoc
03-基板/历史/【1】高端控制器整理完成/【2】高端控制器 最终版电路板汇总/【1】XBTO高端控制盒V1.1/XBTO高端控制盒V1.1/RightInterface.SchDoc
03-基板/历史/【1】高端控制器整理完成/【2】高端控制器 最终版电路板汇总/【1】XBTO高端控制盒V1.1/XBTO高端控制盒V1.1/TTL_TO_RS232.SchDoc
03-基板/历史/【1】高端控制器整理完成/【2】高端控制器 最终版电路板汇总/【1】XBTO高端控制盒V1.1/XBTO高端控制盒V1.1/TTL_TO_RS485.SchDoc
03-基板/历史/【1】高端控制器整理完成/【2】高端控制器 最终版电路板汇总/【1】XBTO高端控制盒V1.1/XBTO高端控制盒V1.1/XBOT高端控制盒V1_1.PrjPcb
03-基板/历史/【1】高端控制器整理完成/【2】高端控制器 最终版电路板汇总/【1】XBTO高端控制盒V1.1/XBTO高端控制盒V1.1/控制盒基板1.PcbLib
03-基板/历史/【1】高端控制器整理完成/【2】高端控制器 最终版电路板汇总/【1】XBTO高端控制盒V1.1/XBTO高端控制盒V1.1/控制盒基板2.PcbLib
03-基板/历史/【1】高端控制器整理完成/【2】高端控制器 最终版电路板汇总/【1】XBTO高端控制盒V1.1/XBTO高端控制盒V1.1/控制盒基板-布局备份.PcbDoc
03-基板/历史/【1】高端控制器整理完成/【2】高端控制器 最终版电路板汇总/【1】XBTO高端控制盒V1.1/XBTO高端控制盒V1.1/测试用.SchDoc
03-基板/历史/【1】高端控制器整理完成/【2】高端控制器 最终版电路板汇总/【2】方向组合按键衬板/组合按键衬板.PcbDoc
03-基板/历史/【1】高端控制器整理完成/【2】高端控制器 最终版电路板汇总/【3】Ｈ区按键衬板/H区按键衬板.PcbDoc
03-基板/历史/【1】高端控制器整理完成/【2】高端控制器 最终版电路板汇总/【5】ＡＢ按键/控制盒AB区8按键.PcbDoc
03-基板/历史/【1】高端控制器整理完成/【2】高端控制器 最终版电路板汇总/【6】IJM组合按键/高级控制盒IJM区组合.PcbDoc
03-基板/历史/【1】高端控制器整理完成/【2】高端控制器 最终版电路板汇总/【7】IJ区按键衬板/衬板.PcbDoc
03-基板/历史/【1】高端控制器整理完成/【2】高端控制器 最终版电路板汇总/【8】摇杆/摇杆总图.PcbDoc
03-基板/电气设计/CT310高端控制盒基板电路设计/CT310高端控制盒各按键电路V1.0/1.左摇杆(已投)/1.CT310高端控制盒左摇杆电路V1.0/CT310高端控制盒左摇杆电路V1.0.PcbDoc
03-基板/电气设计/CT310高端控制盒基板电路设计/CT310高端控制盒各按键电路V1.0/1.左摇杆(已投)/1.CT310高端控制盒左摇杆电路V1.0/CT310高端控制盒左摇杆电路V1.0.PrjPcb
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
