wuxinyou/05-XBotHighCtrlBox/02-核心板/叶总资料/xbot/qtxbot8(pc3)/src/focaldis.h

/***************************************************************************
 *   Copyright (C) 2006-2008 by Tomasz Ziobrowski                          *
 *   http://www.3electrons.com                                             *
 *   e-mail: t.ziobrowski@3electrons.com                                   *
 *                                                                         *
 *                                                                         *
 *   This program is free software; you can redistribute it and/or modify  *
 *   it under the terms of the GNU General Public License as published by  *
 *   the Free Software Foundation; either version 2 of the License, or     *
 *   (at your option) any later version.                                   *
 *                                                                         *
 *   This program is distributed in the hope that it will be useful,       *
 *   but WITHOUT ANY WARRANTY; without even the implied warranty of        *
 *   MERCHANTABILITY or FITNESS FOR A PARTICULAR PURPOSE.  See the         *
 *   GNU General Public License for more details.                          *
 *                                                                         *
 *   You should have received a copy of the GNU General Public License     *
 *   along with this program; if not, write to the                         *
 *   Free Software Foundation, Inc.,                                       *
 *   59 Temple Place - Suite 330, Boston, MA  02111-1307, USA.             *
 ***************************************************************************/

#ifndef FOCALDIS_H
#define FOCALDIS_H

#include "abstractmeter.h"

    class FocalDis : public AbstractMeter
    {
      Q_OBJECT 
      public:
    	FocalDis(QWidget *parent = 0);
      protected:
        void paintEvent(QPaintEvent *event); 	  // inherited form WidgetWithBackground
		void paintBackground(QPainter & painter); // inherited form WidgetWithBackground
		void initCoordinateSystem(QPainter & painter);
    };
#endif // FOCALDIS_H
