wuxinyou/05-XBotHighCtrlBox/02-核心板/软件设计-历史/qtxbot4412_20170221/src/modle_2d.h

#ifndef MYMODULE_H
#define MYMODULE_H

#include <qwidget.h>
#include <qevent.h>
#include <qpainter.h>
#include <qstring.h>
#include <qtextcodec.h>
#include <qnamespace.h>
#include <QPoint>

class Modle_2d : public QWidget
{
    Q_OBJECT

public:
     Modle_2d( QWidget* parent);
    ~Modle_2d();
	bool disflag;
public Q_SLOTS:
    void setDis(bool);
    void setValue_1(int);
    void setValue_2(int);
    void setValue_3(int);
    void setValue_4(int);
    void setValue_5(int);
    void setValue_6(int);
    void setValue_7(int);
    void setValue_8(int);
    void setValue_9(int);
    void setValue_10(int);
    void setValue_11(int);              
    int getValue_1();
    int getValue_2();
    int getValue_3();
    int getValue_4();
    int getValue_5();
    int getValue_6();
    int getValue_7();
    int getValue_8();
    int getValue_9();
    int getValue_10();
    int getValue_11();


protected:
	void initCoordinateSystem(QPainter & painter);
  	void paintEvent(QPaintEvent *event); 
  	
private:

	int value_1;
	int value_2;
	int value_3;
	int value_4;
	int value_5;
	int value_6;
	int value_7;
	int value_8;
	int value_9;
	int value_10;
	int value_11;  
   
};

#endif // MYMODULE_H
