wuxinyou/05-XBotHighCtrlBox/02-核心板/软件设计-历史/qtxbot4412_20170221/src/dialog.h

#ifndef DIALOG_H
#define DIALOG_H

#include "ui_dialog.h"
class Dialog : public QDialog, public Ui::dialog
{
	Q_OBJECT
public:
	Dialog( QWidget * parent = 0);
private slots:
	 Q_SIGNALS:
	 void showmainwin();
protected:
	void mouseMoveEvent(QMouseEvent *e);
	void mousePressEvent(QMouseEvent *e);
private:	
	QPoint last;
	QPoint pos0;
};
#endif
