wuxinyou/05-XBotHighCtrlBox/(commit log)

2017-02-23 commit 02-软件设计
2017-02-23 add 02-软件设计/readMe.txt
2017-04-07 备份20170407
2017-04-07 备份20170407-10:01
2017-04-07 修改 系统设计
    [XBOT510高端控制盒通讯协议20170105.xlsx, XBOT510高端控制盒通讯协议20170215.xlsx]
2017-04-07 添加：03-基板
    [BAT_TO_ADC.SchDoc, FrameWork.SchDoc, H区按键衬板.PcbDoc, JoyStickAdcInput.SchDoc, KeyInput_ABH.SchDoc, KeyInput_IJMEF.SchDoc, KeyInput_MG.SchDoc, LeftInterface.SchDoc]
2017-04-07 添加 03-基板
2017-04-07 修改：02-核心板
    [XBOT510高端控制盒通讯协议20170215 - 副本.xlsx, XBOT510高端控制盒通讯协议20170215.xlsx]
2017-04-07 1.完善接收数据延迟的问题；2.修正I1按键的功能
    [XBOT510高端控制盒通讯协议201700407.xlsx, XBOT510高端控制盒通讯协议20170215 - 副本.xlsx]
2017-04-07 备份 20170407下班
    [XBOT510高端控制盒通讯协议201700407.xlsx]
2017-04-08 备份20170408 14：57
    [XBOT510高端控制盒通讯协议201700407.xlsx]
2017-04-08 备份20170408 16:50
2017-04-13 备份20170413
    [高端控制盒项目研发进度表.xlsx]
2017-04-17 基板程序添加长按开关机，测试通过
    [XBOT510高端控制盒通讯协议201700407.xlsx, 高端控制盒项目研发进度表.xlsx]
2017-04-18 备份20170418
    [XBOT510高端控制盒通讯协议201700407.xlsx]
2017-04-18 备份20170418：完善核心板接收基板数据时，错乱的问题
    [XBOT510高端控制盒通讯协议201700407.xlsx]
2017-04-19 添加开机界面Logo
2017-04-27 完善视频视角被截屏的问题
    [BAT_TO_ADC.SchDoc, CT310高端控制盒AB按键电路V1.0.PcbDoc, CT310高端控制盒AB按键电路V1.0.PrjPcb, CT310高端控制盒AB按键电路V1.0.SchDoc, CT310高端控制盒AB按键电路V1.0.step, CT310高端控制盒AB按键电路V1.0.xlsx, CT310高端控制盒AB按键电路V1.1.PcbDoc, CT310高端控制盒AB按键电路V1.1.PrjPcb]
2017-04-28 1.基板添加核心板电源控制；2.添加机械设计资料
    [CT310高端控制盒基板电路V1.0.PrjPcb, Processor.SchDoc, 挂装盒底.SLDPRT, 挂装盒底.STL, 挂装盒盖.SLDPRT, 挂装盒盖.STL, 机械外采件统计.xls]
2017-05-08 备份 20170508
    [CT310高端控制盒A区按键电路V1.0(ok).xlsx, CT310高端控制盒A区按键电路V1.0.PcbDoc, CT310高端控制盒B区按键电路V1.0(ok).xlsx, CT310高端控制盒B区按键电路V1.0.PcbDoc, CT310高端控制盒H区按键电路V1.0(ok).xlsx, CT310高端控制盒H区按键电路V1.0.PcbDoc, CT310高端控制盒IJ区按键电路V1.0(ok).xlsx, CT310高端控制盒IJ区按键电路V1.0.PcbDoc]
